DejaVure/RP-Hausarbeit/deckblatt.tex

\begin{titlepage}
	\begin{flushright}
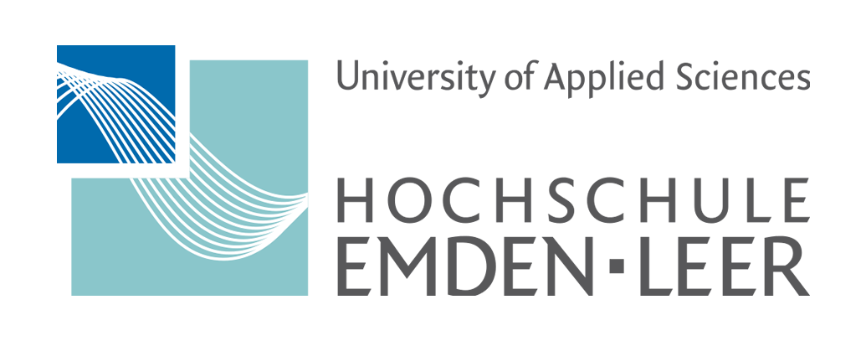
[picture p1: 1_Abbildungen/logoHSEL.png]
		
	\end{flushright}
	\vspace{1 cm}
	\centering
	{\LARGE \textbf{Projektarbeit - Rapid Prototyping}}\\[1cm]
	Studiengang: Maschinenbau \& Design\\
	Abgabedatum: 1. September 2026\\
	\vspace{1cm}
	\textbf{Aufgabe: Halter für die Getriebeausstellung entwerfen und drucken.}\\

	%\today\\[0.25cm]
	\vfil
	%\rule{\textwidth}{0.5pt}
	\vfill
	
	\begin{figure}[H]
		\centering
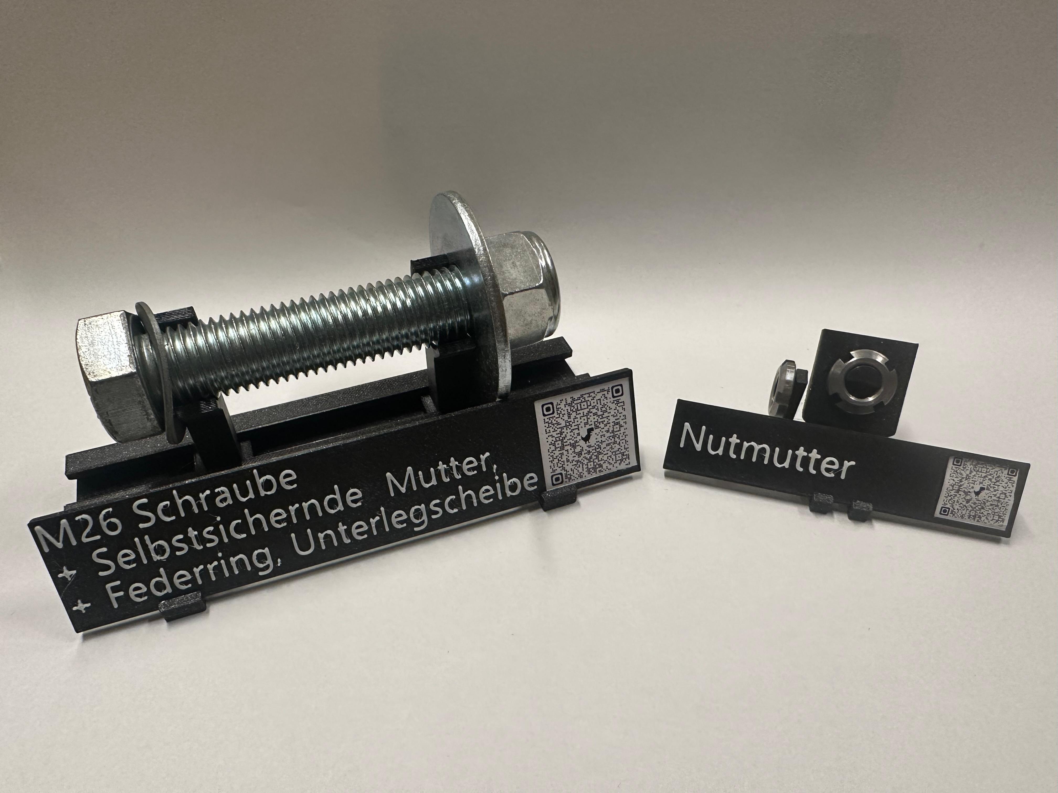
[picture p2: 1_Abbildungen/alleTeile.png]
		
		%\caption{Beispielabbildung}
		%\label{fig:beispiel}
	\end{figure}
	
	\vfill
	
	\begin{tabular}{ll}
		\textbf{Gruppe 4} & \\
		\hline
		Name & Matrikelnummer \\
		\hline
		Carl Maschke   & 7024640 \\
		Sven Neumann   & 7025068 \\
		\hline
	\end{tabular}
	
	\vfill
\end{titlepage}
