DejaVure/RP-Hausarbeit/header.tex

\usepackage[a4paper, top=2cm, bottom=3cm, left=2.5cm, right=2.5cm]{geometry}

\usepackage[utf8]{inputenc}
\usepackage[T1]{fontenc}
\usepackage[ngerman]{babel}

\usepackage{pdfpages}  

\usepackage{subcaption}
\renewcommand{\thesubfigure}{\arabic{subfigure}}

\usepackage{comment}
\usepackage{graphicx}
\usepackage{amsmath}
\usepackage{siunitx}
\usepackage{booktabs}
\usepackage{float}
%\usepackage{hyperref} ersetzt mit Zeile unten, legt Farben für Links fest
\usepackage[colorlinks=true, linkcolor=black, citecolor=black, urlcolor=black]{hyperref}
\usepackage{makecell}
\usepackage{rotating}
\usepackage{cellspace}
\usepackage{tabularx}
\usepackage{array}
\usepackage{caption}

\graphicspath{{1_Abbildungen/}}
\sisetup{locale = DE}

\usepackage{fancyhdr}
\setlength{\parindent}{0pt}
\setlength{\parskip}{0pt}

% ===== biblatex einbinden =====
\usepackage[style=authoryear, backend=biber]{biblatex}

% Zitierformat auf Nur-Norm-Kennung umstellen
\DeclareFieldFormat{cite}{\mkbibparens{#1}}
\renewbibmacro*{cite}{%
	\printfield{number}%
	\setunit{\addcolon\addspace}%
	\printfield{year}%
}

\addbibresource{2_Quellen/literatur.bib} % Pfad zu deiner Bib-Datei
