DejaVure/RP-Hausarbeit/0_Kapitel/Diskussion.tex

\section{Diskussion}
\begin{comment}
	\textcolor{red}{Abgleich mit den Zielsetzungs-Kriterien, Druckherausforderungen (Schwindung, Stützstrukturen, Nacharbeit), Abweichungen.}
\end{comment}

Die aufgetretenen Druckfehler können auf mehrere mögliche Ursachen zurückgeführt werden. Das beobachtete Stringing könnte auf einen erhöhten Feuchtigkeitsgehalt des verwendeten Filaments hindeuten. Durch die im Filament enthaltene Feuchtigkeit kann es beim Erhitzen zu einer unkontrollierten Materialabgabe aus der Düse kommen. Als weitere mögliche Ursache kommen nicht optimal eingestellte Drucktemperaturen infrage. Eine zu hohe Drucktemperatur kann dazu führen, dass das Filament während der Leerfahrten stärker aus der Düse austritt.\\

Die festgestellten Einfallstellen können ebenfalls verschiedene Ursachen haben. Eine mögliche Ursache ist der Verzicht auf Stützstrukturen. Insbesondere bei Bereichen mit Überhängen kann das aufgetragene Filament ohne ausreichende Unterstützung nicht vollständig getragen werden und sich verformen. Alternativ kann auch ein ungünstiger Druckablauf für die Entstehung der Einfallstellen verantwortlich sein.\\

Da alle Haltearme in gleicher Orientierung gedruckt wurden und die Einfallstellen bei allen Bauteilen an derselben Stelle auftraten, ist ein Zusammenhang mit dem Druckablauf wahrscheinlich. Eine mögliche Erklärung ist, dass die Düse an dieser Stelle jeweils einen Schichtwechsel durchgeführt oder dort die Druckbahn beendet hat. Dadurch könnte sich an dieser Stelle eine lokale Materialanhäufung oder eine ungleichmäßige Abkühlung ergeben haben, wodurch die sichtbare Verformung entstanden sein könnte.

\subsection{Vergleich mit der Anforderungsliste}
Abschließend folgt der Vergleich mit der Anforderungsliste aus Tabelle \ref{tab:zielsetzung}. Die Standsicherheit ist trotz des 15 \% Infills gegeben. Der Halter für die Wellensicherungen hat eine gute Standsicherheit durch sein Eigengewicht. Der Schrauben-Halter hat eine gute Standsicherheit durch das Gewicht der Schrauben. Die Funktion der Maschinenelemente ist bei beiden Haltern sichtbar. Es wurde kostengünstig und materialsparend gearbeitet (190,74 g Filament). Zudem wurden die QR-Codes weitergeführt und die Informativität im Vergleich zu vorher erhöht.
