DejaVure/RP-Hausarbeit/0_Kapitel/Einleitung.tex

\section{Einleitung}
Rapid-Prototyping gewinnt heutzutage immer mehr an Bedeutung. Innerhalb kürzester
Zeit ist ein Bauteil entworfen und mittels 3D-Druck gefertigt. Das spart nicht nur Kosten
für aufwändige Prototypen mit langer Fertigungsdauer, sondern bietet auch den Rahmen
für kleinere Bauteile und Projekte. Diese kleinen Projekte können jedoch eine große
Wirkung erzielen, indem sie individuelle Lösungen erlauben, die vorher nur durch teure
Einzelfertigungen möglich waren.\\

Solch eine individuelle Lösung ist auch im Rahmen des Moduls \textit{Rapid Prototyping}
entstanden. Dabei handelt es sich um eine studentische Projektarbeit im Bereich der
additiven Fertigung mit dem Auftrag, für das Labor für Maschinenelemente Bauteile zu
entwerfen, die als Halter für Verbindungselemente dienen und anschließend additiv
gefertigt werden.\\

 Die vorgefundene Situation im Labor erfordert dabei eine sichere und
didaktisch sinnvolle Halterung für die ausgestellten Maschinenelemente. Nach der
Konzeptfindung wird daher ein Bauteil entworfen und kostengünstig gedruckt.

\subsection{Aufbau der Arbeit}

Anfangs wird die Problemstellung im Labor beschrieben. Daraufhin wird die Zielsetzung
der Gruppenarbeit festgelegt, wobei die genauen Randbedingungen des Bauteils
festgehalten werden. Bevor konstruktiv an dem Bauteil gearbeitet wird, erfolgt eine
Marktrecherche. Im Anschluss werden Lösungsansätze erarbeitet und ein Konzeptvergleich
durchgeführt. Danach folgt die konstruktive Umsetzung. Im nächsten Schritt werden die
Ergebnisse präsentiert und die Ziele im Kapitel Diskussion auf ihre Erfüllung geprüft.
Abschließend folgen ein Fazit sowie ein Ausblick auf weitere Bauteile und Verbesserungen.
