DejaVure/RP-Hausarbeit/main.tex

\documentclass[a4paper,12pt]{article}

\input{Header}

\begin{document}
	
	% =========================
	% Deckblatt (ohne Kopfzeile)
	% =========================
	%\pagestyle{empty}
	
	\input{Deckblatt}
	
	\clearpage
	% =========================
	% Inhaltsverzeichnis
	% =========================
	\pagestyle{empty}
	\tableofcontents
	\clearpage
	% =========================
	% Kopf- und Fußzeilen nach dem Inhaltsverzeichnis
	% =========================
	\pagestyle{fancy}
	\fancyhf{}
	% Kopfzeile
	\fancyhead[L]{}
	\fancyhead[R]{\small \nouppercase{\leftmark}}
	% Fußzeile
	\fancyfoot[L]{\small 1. September 2026}
	\fancyfoot[C]{\small Hausarbeit Rapid Prototyping}
	\fancyfoot[R]{\small \thepage}
	% Linien
	\renewcommand{\headrulewidth}{0.4pt}
	\renewcommand{\footrulewidth}{0.4pt}
	\setlength{\headheight}{32pt}
	% =========================
	% Hauptteil
	% =========================
	\input{0_Kapitel/Einleitung}
	\newpage
	\input{0_Kapitel/Problemstellung}
	\newpage
	\input{0_Kapitel/Zielsetzung}
	\newpage
	%\input{0_Kapitel/Aufbau der Arbeit}
	\newpage
	\input{0_Kapitel/Stand der Technik}
	\newpage
	\input{0_Kapitel/Methoden}
	\newpage
	\input{0_Kapitel/Ergebnisse}
	\newpage
	\input{0_Kapitel/Diskussion}
	\newpage
	\input{0_Kapitel/Zusammenfassung und Fazit}
	\newpage	
	\input{0_Kapitel/Ausblick}	
	\newpage
	% =========================
	% Literatur
	% =========================
	\clearpage
	\pagenumbering{roman}
	\printbibliography[heading=bibintoc]
	\clearpage
	\addcontentsline{toc}{section}{Abbildungsverzeichnis}
	\listoffigures
	\clearpage
	\addcontentsline{toc}{section}{Tabellenverzeichnis}
	\listoftables
	\appendix
	\newpage
	\section{Baugruppenzeichnungen}
	\includepdf[pages=1]{3_Anhang/Zeichnungen/Wellensicherung.pdf}
	\includepdf[pages=1]{3_Anhang/Zeichnungen/Schraubenhalter.pdf}

\end{document}
