DejaVure/RP-Hausarbeit/0_Kapitel/Methoden.tex

\section{Konstruktive Umsetzung}

Für die Herstellung der Bauteile wurde das FDM-Verfahren mit den in Tab.~\ref{tab:Prozessparameter für die Herstellung der Bauteile} aufgeführten Prozessparametern und Materialien verwendet.

\begin{table}[H]
	\centering
	\caption{Prozessparameter für die Herstellung der Bauteile}
	\label{tab:Prozessparameter für die Herstellung der Bauteile}
	\begin{tabular}{c|c}		
		\textbf{Prozessparameter} & \textbf{Wert/Einstellung} \\
		\hline
		Hauptfilament & PLA Prusa Galaxy Black \\
		\hline
		Schriftfilament & PLA Weiß \\
		\hline
		Drucktemperaturen & Düse 215\,°C, Druckbett 60\,°C \\
		\hline
		Infill & 15\,\% \\
		\hline
		Schichthöhe & max. 0,2\,mm \\
		\hline
		Druckqualität & hoch \\
	\end{tabular}
\end{table}

Um möglichst viel Filament einzusparen, wurden die Bauteile so konstruiert und auf dem Druckbett ausgerichtet, dass bis auf die Adapter für die Sicherungen keine Stützstrukturen benötigt werden. Dies wurde dadurch erreicht, dass die Neigungen der Bauteile einen Winkel von 45° nicht unterschreiten und Übergänge, soweit möglich, durch Schrägen ausgeführt wurden. Für alle Bauteile, die ineinander gesteckt oder aufgesteckt werden, wurden Toleranzen von 0,1--0,3\,mm berücksichtigt.

Für die Informationstexte wurde der Slicer von Prusa verwendet. Dafür wurde eine unbeschriftete Platte mit den Abmessungen 150\,x\,30\,mm für die Schraubenbeschriftung und eine Platte mit den Abmessungen 90\,x\,20\,mm für die Sicherungen als Grundplatte in den Slicer importiert, siehe Abb. \ref{fig:Platen im Slicer}. Anschließend wurden die gewünschten Beschriftungen mit der Funktion ``Text'' auf die Platten aufgetragen. Um einen farblichen Kontrast zur Grundplatte zu schaffen, wurde ab der ersten Schicht der Beschriftung ein Farbwechsel eingeplant.

\begin{figure}[H]
	\centering
	
	\caption{Platte für die Sicherungen mit Einlassung zum Einklemmen von QR-Codes}
	\label{fig:Platte in Fusion}
\end{figure}

In die Platten wurden zusätzlich Einlassungen konstruiert, um die QR-Codes zur Internetseite des Maschinenelemente-Labors einzuklemmen (siehe Abb.~\ref{fig:Platte in Fusion}). Dies wurde umgesetzt, da es technisch nicht möglich war, die QR-Codes in einer für die Platte geeigneten Größe direkt auf die Platten aufzubringen und gleichzeitig eine ausreichende Lesbarkeit sicherzustellen.

\begin{figure}[H]
	\centering
	
	\caption{Beschriftete Platten für die Sicherungen im Slicer}
	\label{fig:Platen im Slicer}
\end{figure}

%//////////////////////////////////////////////////////////////////////////////////

\subsection{Halter für die Schrauben}

Um die Möglichkeit zu schaffen, bei einem Tausch oder Hinzufügen von Schrauben mit unterschiedlichen Längen nicht die gesamte Halterung neu konstruieren zu müssen, wurde die Basis des Schraubenhalters mit einer Schiene konstruiert. Diese ermöglicht die Einstellung unterschiedlicher Abstände (siehe Abb.~\ref{fig:Schrauben_Basis}).

Um die Platten mit den Informationstexten halten zu können, wurden die Arme der Basis mit schrägen Einkerbungen versehen. Diese ermöglichen das Einsetzen und Halten der Platten (siehe Abb.~\ref{fig:Schrauben_Basis}).

\begin{figure}[H]
	\centering
	
	\caption{Basis des Schraubenhalters}
	\label{fig:Schrauben_Basis}
\end{figure}

Um auch verschiedene Schraubendurchmesser ausstellen zu können, wurde für die Haltearme ein Mustermodell erstellt. In diesem Modell kann der gewünschte Durchmesser direkt in der Skizze eingegeben werden, woraufhin die restlichen Maße automatisch angepasst werden. Durch die Schienen an der Basis und die entsprechenden Gegenstücke an den Haltearmen können die Haltearme einfach ausgetauscht werden.

\begin{figure}[H]
	\centering
	
	\caption{Haltearme der Schrauben für die unterschiedlichen Schraubendurchmesser}
	\label{fig:Haltearme_Schrauben}
\end{figure}

Die Grundfläche der gesamten Halterung beträgt 150\,x\,87\,mm. Da die Haltearme mit unterschiedlichen Durchmessern auch unterschiedlich hoch sind, liegt die Höhe der Halterung zwischen 46,62\,mm für die M16-Schraube und 60,25\,mm für die M33-Dehnschraube. Die fertige Halterung für die Schrauben ist in Abb. \ref{fig:schraubenhalter} zu sehen.

\begin{figure}[H]
	\centering
	
	\caption{CAD-Modell des fertigen Schraubenhalters}
	\label{fig:schraubenhalter}
\end{figure}

%//////////////////////////////////////////////////////////////////////////////////

\subsection{Halter für die Wellensicherungen}

Von den Sicherungen sind jeweils zwei Exemplare in der Glasvitrine vorhanden. Daher wurde eine Basis gewählt, bei der jeweils eine Sicherungsart in der Frontansicht angeordnet wird und die zweite Ausführung in der Seitenansicht daneben hängt. Die Platte mit dem Informationstext wird ähnlich wie bei der Schraubenhalterung in die Stützen der Basis eingesteckt (siehe Abb.~\ref{fig:Basis_Sicherungen}).

\begin{figure}[H]
	\centering
	
	\caption{Basis der Halterung für die Sicherungen}
	\label{fig:Basis_Sicherungen}
\end{figure}

\newpage

Um auch hier die Möglichkeit zu schaffen, verschiedene Sicherungselemente mit unterschiedlichen Durchmessern ausstellen zu können, werden sogenannte Adapter (siehe Abb.~\ref{fig:Adapter_Sicherungen}) in die Öffnung der Basis gesteckt. Die Adapter wurden so konstruiert, dass entweder möglichst viele Details der jeweiligen Sicherung sichtbar sind oder die vorgesehene Verwendung der Sicherung angedeutet wird.

\begin{figure}[H]
	\centering
	
	\caption{Passende Adapter für die auszustellenden Sicherungen}
	\label{fig:Adapter_Sicherungen}
\end{figure}

Die Maße der Halterung betragen 43,34\,x\,33\,x\,30,24\,mm. Das fertige CAD-Modell für den Halter der Wellensicherungen ist in Abb. \ref{fig:wellensicherungHalter} zu sehen.

\begin{figure}[H]
	\centering
	
	\caption{CAD-Modell des fertigen Wellensicherungs-Halters}
	\label{fig:wellensicherungHalter}
\end{figure}
