DejaVure/RP-Hausarbeit/0_Kapitel/Stand der Technik.tex

\section{Stand der Technik}

\subsection{Marktrecherche}
Im Internet sind viele Werkzeughalter zu finden. Diese sind jedoch auf bestimmte Werkzeuge, aber nicht auf einzelne Maschinenelemente abgestimmt. Als Beispiel dient ein Wandhalter für Werkzeug von \textit{Amazon} (siehe Abb. \ref{fig:amazonHalter}).

\begin{figure}[H]
	\centering
	
	\caption{Kommerzieller Halter für Werkzeug (Amazon.de:2026)} \nocite{Amazon2026}
	\label{fig:amazonHalter}
\end{figure}

Eine Halterung aus Holz wäre nachhaltiger als ein Filament aus dem 3D-Drucker, jedoch für das Modul Rapid-Prototyping nicht relevant, da die additive Fertigung Teil der Aufgabenstellung ist.\\

Des Weiteren sind auch Lochwände als allgemeine Werkstattlösung zur geordneten Platzierung von Werkzeug geeignet. Hier gibt es jedoch auch keine geeigneten verfügbaren Halter für einzelne Maschinenelemente; lediglich für definiertes Werkzeug, wie in Abb. \ref{fig:lochwand} zu sehen ist. Auch hier müssten erst individuelle Halter für die Lochwand gefertigt werden (auch als 3D-Druck möglich).

\begin{figure}[H]
	\centering
	
	\caption{Kommerzielle Lochwand für Werkzeug (Lochwand.de:2026)} \nocite{Lochwand2026}
	\label{fig:lochwand}
\end{figure}

\subsection{Lösungsansätze}
\subsubsection{Schraubenhalter}
Für den Schraubenhalter wurde zuerst die Idee der Lochwand aufgegriffen, wie in Abb. \ref{fig:halter1} zu sehen ist. Dabei müssen der Halter und das Lochbrett jeweils gefertigt werden. Das Lochbrett hat ein einheitliches Muster und kann auch für spätere Anwendungen genutzt werden. Der Halter benötigt auf der einen Seite eine Aufnahme für die Schraube und auf der anderen Seite einen Stift, um sich formschlüssig oder durch eine Klemmverbindung mit dem Lochbrett zu verbinden.
\begin{figure}[H]
	\centering
	
	\caption{Konzept 1 für Schraubenhalter}
	\label{fig:halter1}
\end{figure}

Eine weitere Idee ist ein variabler Halter, der mit Adaptern jede Schraube tragen kann (siehe Abb. \ref{fig:halter2}). Bei diesem Konzept wird der Halter einmal gefertigt und es müssen lediglich die Adapter verändert werden, damit man die Schrauben variieren kann. 

\begin{figure}[H]
	\centering
	
	\caption{Konzept 2 für Schraubenhalter}
	\label{fig:halter2}
\end{figure}
\newpage

\subsubsection{Wellensicherungs-Halter}
Für den Wellensicherungs-Halter ist die Idee mit dem Lochbrett ebenfalls aufgenommen worden (siehe Abb. \ref{fig:halter3}). Dabei kann man einen Wellenabsatz in das Lochbrett stecken und das Wellensicherungselement auf die Welle montieren.

\begin{figure}[H]
	\centering
	
	\caption{Konzept 1 für Wellensicherungs-Halter}
	\label{fig:halter3}
\end{figure}

Ein weiteres Konzept ist ein Halter mit geneigter Fläche (siehe Abb. \ref{fig:halter4}). Dabei werden die Wellensicherungen auf einer geneigten Grundfläche ebenfalls auf kleinen Wellenabsätzen montiert. Zusätzlich ist eine Infotafel mit der Möglichkeit eines QR-Codes verbaut.

\begin{figure}[H]
	\centering
	
	\caption{Konzept 2 für Wellensicherungs-Halter}
	\label{fig:halter4}
\end{figure}
\newpage

\subsection{Konzeptvergleich}
Zuerst werden die beiden Konzepte mit den gewichteten Kriterien aus Tabelle \ref{tab:zielsetzung} in einer Bewertungsmatrix verglichen, siehe Tabelle \ref{tab:bewertung_schraubenhalter}. Dabei wird eine Punkteskala von 0-10 (0 = schlecht, 10 = sehr gut) verwendet. 

\begin{table}[H]
	\centering
	\caption{Bewertungsmatrix Schraubenhalter}
	\label{tab:bewertung_schraubenhalter}
	\begin{tabular}{l c cc cc}
		\toprule
		& & \multicolumn{2}{c}{Konzept 1: Lochbrett} & \multicolumn{2}{c}{Konzept 2: Adapter} \\
		\cmidrule(lr){3-4} \cmidrule(lr){5-6}
		Kriterium & Gewichtung & Punkte & Gewichtet & Punkte & Gewichtet \\
		\midrule
		Tragfähigkeit   & 0,25 & 7 & 1,75 & 9 & 2,25 \\
		Standsicherheit & 0,20 & 5 & 1,00 & 9 & 1,80\\
		Materialsparend & 0,15 & 6 & 0,90 & 5 & 0,75\\
		Kostengünstig   & 0,15 & 6 & 0,90 & 5 & 0,75\\
		Wenig Bauteile  & 0,10 & 9 & 0,90 & 3 & 0,30\\
		Informativ      & 0,10 & 3 & 0,30 & 3 & 0,30\\
		Ästhetisch      & 0,05 & 4 & 0,20 & 5 & 0,25\\
		\midrule
		\textbf{Summe}  & 1,00 & & \textbf{5,95} & & \textbf{6,40} \\
		\bottomrule
	\end{tabular}
\end{table}

Aus der Tabelle \ref{tab:bewertung_schraubenhalter} geht das Konzept 2 als besser hervor. Für die beiden Konzepte der Wellensicherungs-Halter wurde ebenfalls eine Bewertungsmatrix angelegt (siehe Tabelle \ref{tab:bewertung_wellensicherung})

\begin{table}[H]
	\centering
	\caption{Bewertungsmatrix Wellensicherungs-Halter}
	\label{tab:bewertung_wellensicherung}
	\begin{tabular}{l c cc cc}
		\toprule
		& & \multicolumn{2}{c}{Konzept 1: Lochbrett} & \multicolumn{2}{c}{Konzept 2: geneigte Fläche} \\
		\cmidrule(lr){3-4} \cmidrule(lr){5-6}
		Kriterium & Gewichtung & Punkte & Gewichtet & Punkte & Gewichtet \\
		\midrule
		Tragfähigkeit   & 0,25 & 8 & 2,00 & 10 & 2,50 \\
		Standsicherheit & 0,20 & 8 & 1,60 & 10 & 2,00\\
		Materialsparend & 0,15 & 7 & 1,05 & 5 & 0,75\\
		Kostengünstig   & 0,15 & 6 & 0,90 & 6 & 0,90\\
		Wenig Bauteile  & 0,10 & 8 & 0,80 & 8 & 0,80\\
		Informativ      & 0,10 & 4 & 0,40 & 10 & 1,00\\
		Ästhetisch      & 0,05 & 4 & 0,20 & 6 & 0,30\\
		\midrule
		\textbf{Summe}  & 1,00 & & \textbf{6,95} & & \textbf{8,25} \\
		\bottomrule
	\end{tabular}
\end{table}

Aus der Tabelle \ref{tab:bewertung_wellensicherung} geht das Konzept 2 als bessere Variante hervor.
