DejaVure/RP-Hausarbeit/0_Kapitel/Ergebnisse.tex

\section{Ergebnisse}

\begin{comment}
	\textcolor{red}{Renderings, Slicer-Vorschau, Druckfotos, Soll-Ist-Maßvergleich, Gewicht/Druckzeit als Beleg für "materialsparend" aus der Zielsetzung.}
\end{comment}

Die 3D-erzeugten Bauteile konnten mit 190,74 g (63,96 m) an Filament hergestellt werden. Bei fast allen Bauteilen konnte auf Stützstrukturen verzichtet werden, wodurch Zeit und Material eingespart werden konnten. Trotz eines Infills von 15\,\% konnten die Bauteile ausreichend stabil und standsicher hergestellt werden. Die Arme an den Halterungen sowie die Haltearme für die Schrauben wurden hierfür etwas massiver ausgelegt.

Aufgrund der relativ großen Schrift auf den Platten mussten Informationen zu den Schrauben teilweise weggelassen werden. Die Qualität der Schrift weist an mehreren Stellen sichtbare Druckfehler auf (siehe Abb.~\ref{fig:Schrift der Platten}).

\begin{figure}[H] 
	\centering 
	
	\caption{Druckfehler bei der erzeugten Schrift} 
	\label{fig:Schrift der Platten} 
\end{figure}

Die Bauteile konnten bis auf wenige Stellen, an denen Stringing aufgetreten ist, nahezu fehlerfrei hergestellt werden. Bei einer Basis für eine Sicherungshalterung ist im Bereich des Lochs das Material etwas eingefallen (siehe Abb.~\ref{fig:Einfall in Loch}).

\begin{figure}[H]
	\centering
	
	\caption{Druckfehler: eingefallene Stelle im Loch}
	\label{fig:Einfall in Loch}
\end{figure}

Bei allen Haltearmen des Schraubenhalters ist von hinten gesehen auf der rechten Seite eine Einfallstelle am Außendurchmesser zu erkennen (siehe Abb.~\ref{fig:Einfall im Haltearm}).

\begin{figure}[H]
	\centering
	
	\caption{Druckfehler: eingefallene Stelle am Haltearm}
	\label{fig:Einfall im Haltearm}
\end{figure}

Die jeweiligen technischen Zeichnungen zu den Haltern sind dem Anhang zu entnehmen.

\newpage

\subsection{Der fertige Halter für Schrauben}

\begin{figure}[H]
	\centering
	
	\caption{Schraubenhalter mit M26 Schraube}
	\label{fig:schraubenhalterFinal}
\end{figure}

\subsection{Der fertige Halter für Wellensicherungen}

\begin{figure}[H]
	\centering
	
	\caption{Die fertigen Halter für Wellensicherungen}
	\label{fig:wellenhalterFinal}
\end{figure}
