DejaVure/RP-Hausarbeit/0_Kapitel/Problemstellung.tex

\section{Problemstellung}

Im Labor für Maschinenelemente sind mechanische Verbindungs- und Maschinenelemente ausgestellt. Einige dieser Bauteile sind in einer Glasvitrine ausgestellt (siehe Abb. \ref{fig:schraubenGesamt}). Das Problem hierbei ist, dass einige der mechanischen Verbindungselemente ein hohes Gewicht haben und beim unbeabsichtigt zu starken Ablegen das Glas beschädigen könnten. Zudem liegen die Bauteile ungeordnet frei herum. Die einzelnen Schrauben sind zudem in Abb. \ref{fig:schrauben} zu sehen.

\begin{figure}[H]
	\centering
	
	\caption{Verbindungselemente liegen auf der Glasplatte}
	\label{fig:schraubenGesamt}
\end{figure}

Zusätzlich befinden sich noch axiale Wellensicherungselemente in der Glasvitrine, siehe dazu Abb. \ref{fig:sicherungsringe}. \\
In Abb. \ref{fig:sicherungsringe} liegen die Sicherungselemente auf einer Holzplatte für eine bessere Sichtbarkeit. Diese liegen ebenfalls regellos in der Vitrine und sind schlecht sichtbar. Zudem lässt sich die spätere Funktion als  Maschinenelement auf den ersten Blick nicht erkennen.

\begin{figure}[H]
	\centering
	
	\caption{Axiale Wellensicherungen sind ungeordnet verteilt}
	\label{fig:sicherungsringe}
\end{figure}
\newpage

Im Detail sind es folgende Schrauben und Wellensicherungen:
\begin{enumerate}
	\item Schraubenbolzen mit Dehnschaft M33 x 180 mm \parencite{DIN2510}
	\item Sechskantschraube mit Schaft M24 x 120 mm \parencite{DIN931}
	\item Sechskantschraube mit Vollgewinde M16 x 80 mm \parencite{DIN933}
	\item Sechskantschraube mit Vollgewinde M20 x 100 mm \parencite{DIN933}
	\item Nutmutter M10 x 1 \parencite{DIN981}
	\item Sicherungsring für Wellen \O10 mm \parencite{DIN471}
	\item Sicherungsblech für Nutmutter \O10 mm \parencite{DIN5406}
\end{enumerate}

\begin{figure}[htbp]
	\centering
	
	% Oben
	\begin{subfigure}[c]{0.45\textwidth}
		\centering
		
		\caption{M33 -- DIN 2510}
		\label{fig:M33-DIN2510}
	\end{subfigure}
	\hfill
	\begin{subfigure}[c]{0.45\textwidth}
		\centering
		
		\caption{M24 -- DIN 931}
		\label{fig:M24-DIN931}
	\end{subfigure}
	
	\vspace{0.8cm}
	
	% Unten
	\begin{subfigure}[c]{0.45\textwidth}
		\centering
		
		\caption{M16 -- DIN 933}
		\label{fig:M16-DIN933}
	\end{subfigure}
	\hfill
	\begin{subfigure}[c]{0.45\textwidth}
		\centering
		
		\caption{M20 -- DIN 933}
		\label{fig:M20-DIN933}
	\end{subfigure}
	
	\caption{Verwendete Schrauben}
	\label{fig:schrauben}
\end{figure}
