DejaVure/RP-Hausarbeit/0_Kapitel/Zielsetzung.tex

\section{Zielsetzung}
Als Zielsetzung wurde die in Tabelle \ref{tab:zielsetzung} dargestellte Anforderungsliste nach Muss-/Soll-/Kann-Kriterien erstellt:\\

\begin{table}[H]
	\centering
	\caption{Anforderungsliste}
	\label{tab:zielsetzung}
	\begin{tabular}{c|c|c}		
		\textbf{Muss} & \textbf{Soll} & \textbf{Kann} \\
		\hline
		Tragfähigkeit & Informativ & Ästhetisch \\
		\hline
		Standsicherheit & Kostengünstig & Abnehmbare Infotafel \\
		\hline
		Additiv Fertigbar & Materialsparend & \\
		\hline
		Funktion sichtbar & Wenig Bauteile & \\
	\end{tabular}
\end{table}

Die Standsicherheit ist entscheidend für den Halter, da größere Verbindungselemente, wie die M33-Schraube, nicht auf die Glasvitrine fallen dürfen; andernfalls entsteht ein irreversibler Schaden an der Glasvitrine. Der Halter muss zudem das Gewicht des jeweiligen Maschinenelements tragen können; daher ist eine ausreichende Tragfähigkeit erforderlich, um ein späteres Zusammenbrechen des Halters zu vermeiden.\\

Die Funktion der Maschinenelemente soll deutlich gemacht werden. Dazu sollen die dazugehörigen Scheiben, Ringe und Muttern (vgl. Abb. \ref{fig:schraubenGesamt}) mit den Maschinenelementen auf dem Halter montiert sein. Materialsparend und wenig Bauteile gehen Hand in Hand: Es soll darauf geachtet werden, nicht für jede Schraube und Wellensicherung, ein komplett neuen Halter zu entwickeln, sondern mit Adaptern etc. zu arbeiten.\\

Auf Abb. \ref{fig:schraubenGesamt} sind bereits QR-Codes zu sehen, diese sollen erhalten bleiben und mit einer abnehmbaren Infotafel ergänzt werden. Damit bleibt das QR-Informationssystem des Labors erhalten.\\

Ästhetisch gesehen soll das Produkt auch ansprechend sein und das Interesse der Studenten wecken und gleichzeitig die Aufmerksamkeit auf das Maschinenelement lenken.
