DejaVure/RP-Hausarbeit/0_Kapitel/Ausblick.tex

\section{Ausblick}

%\textcolor{red}{Z. B. Übertragung auf weitere Vitrinen im Labor, Materialalternativen, Serienfertigung.}

Für zukünftige Anwendungen könnten die Druckparameter weiter optimiert werden, um die Qualität der gedruckten Schrift zu verbessern und Druckfehler wie Stringing und Einfallstellen zu reduzieren. Insbesondere die Drucktemperatur, die Retraktion und die Druckorientierung könnten angepasst und durch weitere Druckversuche optimiert werden.

Darüber hinaus könnte die Farbgestaltung der Halterungen und Bauteile angepasst werden, um einen stärkeren Kontrast zwischen den einzelnen Komponenten zu erreichen. Dadurch könnten die Bauteile in der Ausstellung besser voneinander unterschieden werden.

Auch die Beschriftung der Platten bietet weiteres Verbesserungspotenzial. Eine Anpassung der Schriftgröße und der verwendeten Schriftart könnte zu einer besseren Druckqualität führen. Alternativ könnte die Beschriftung nachträglich aufgebracht werden. Eine direkte Integration der QR-Codes in die Platten wäre ebenfalls wünschenswert, um auf das zusätzliche Ausdrucken und Anbringen verzichten zu können.

Durch die modulare Konstruktion besteht zudem die Möglichkeit, zukünftige Änderungen der Ausstellung mit vergleichsweise geringem Konstruktionsaufwand umzusetzen. Einzelne Halterungen können angepasst oder neu gefertigt werden, ohne die gesamte Konstruktion überarbeiten zu müssen.
