DejaVure/RP-Hausarbeit/1_Abbildungen/Adapter_Sicherungen.png

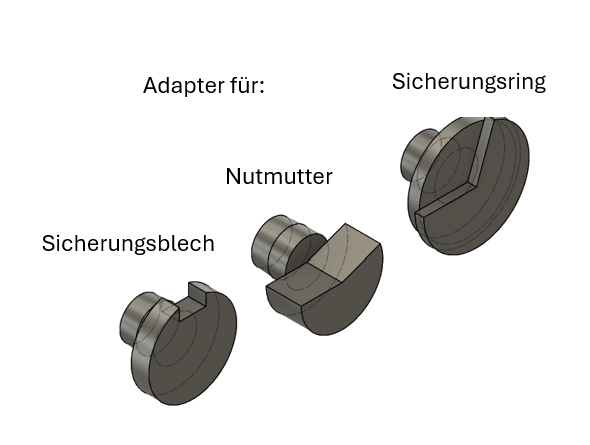
1_Abbildungen/Adapter_Sicherungen.png
