DejaVure/RP-Hausarbeit/1_Abbildungen/amazonHalter.png

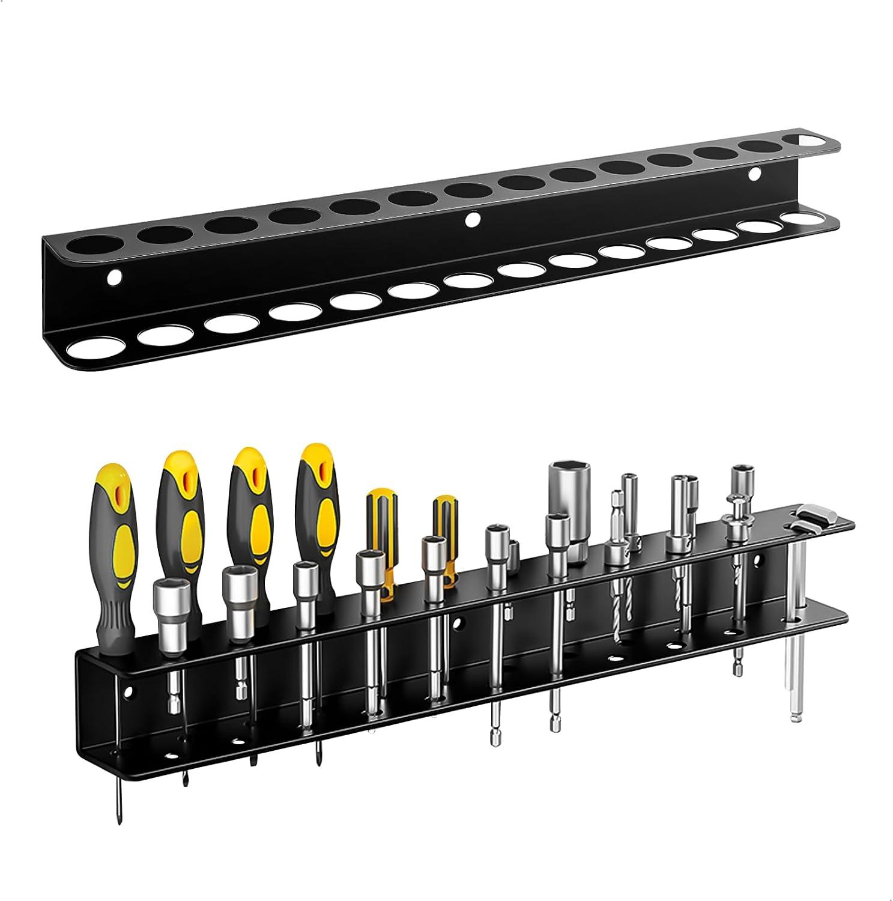
1_Abbildungen/amazonHalter.png
