DejaVure/RP-Hausarbeit/1_Abbildungen/Basis_Schrauben.png

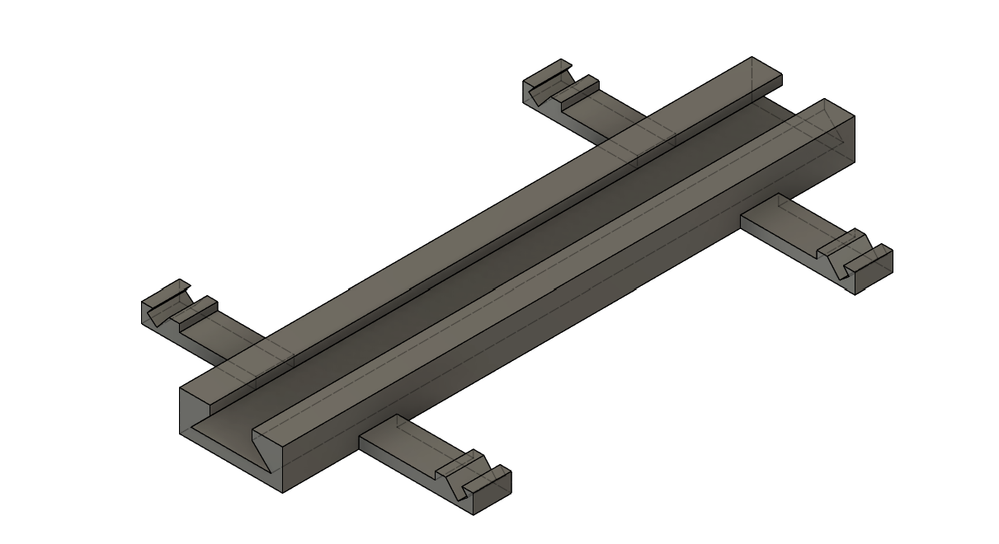
1_Abbildungen/Basis_Schrauben.png
