DejaVure/RP-Hausarbeit/1_Abbildungen/Basis_Sicherungen.png

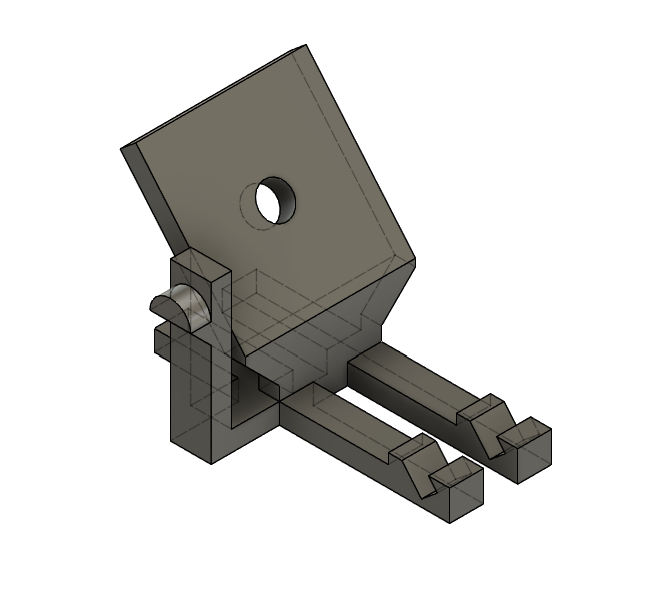
1_Abbildungen/Basis_Sicherungen.png
