DejaVure/RP-Hausarbeit/1_Abbildungen/Beschriftete Platten im Slicer .png

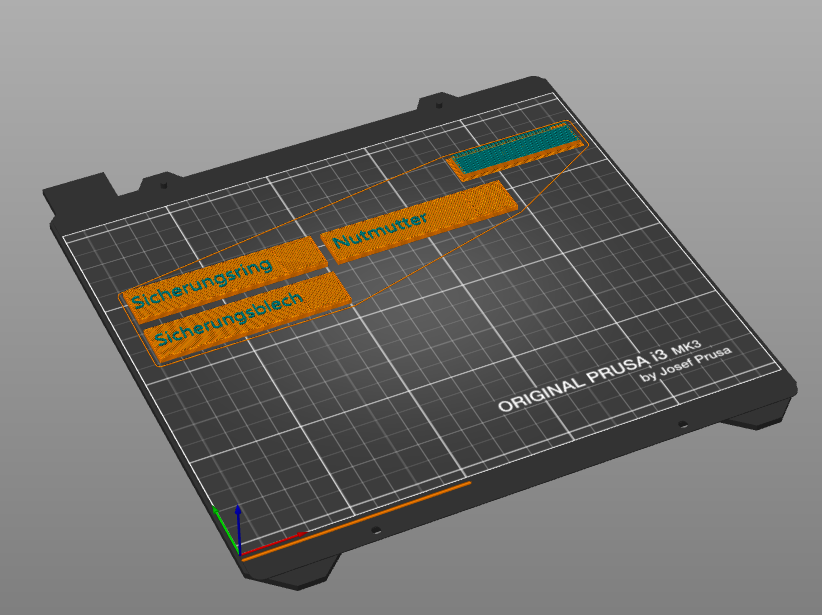
1_Abbildungen/Beschriftete Platten im Slicer .png
