DejaVure/RP-Hausarbeit/1_Abbildungen/dehnschraube.png

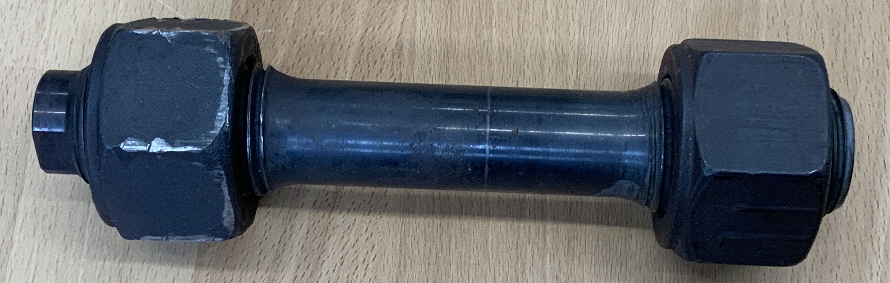
1_Abbildungen/dehnschraube.png
