DejaVure/RP-Hausarbeit/1_Abbildungen/Einfall im Haltearm.jpg

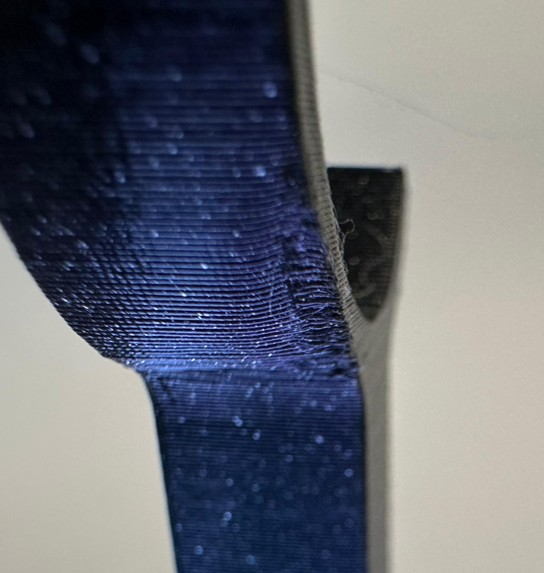
1_Abbildungen/Einfall im Haltearm.jpg
