DejaVure/RP-Hausarbeit/1_Abbildungen/Einfall im Loch.jpeg

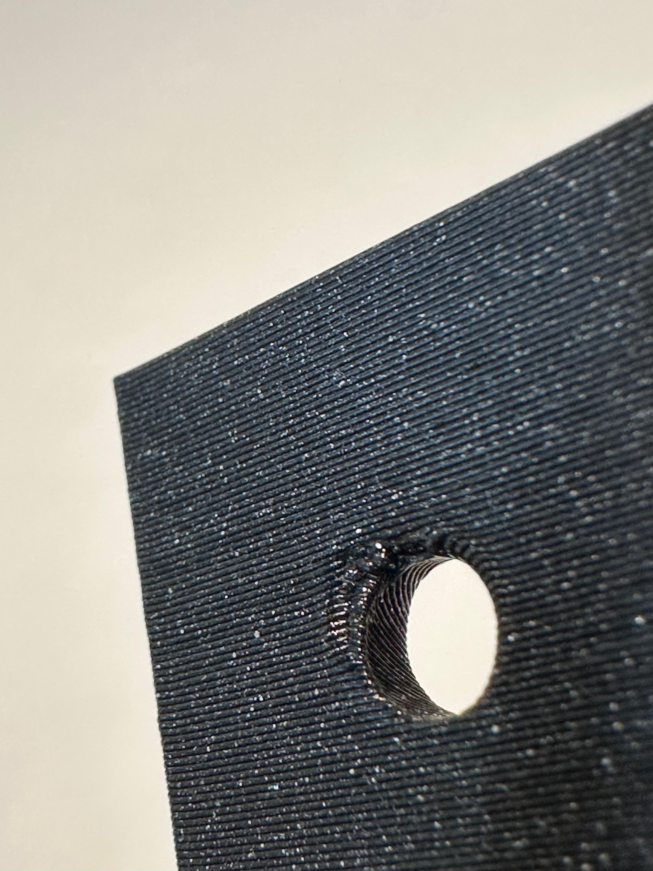
1_Abbildungen/Einfall im Loch.jpeg
