DejaVure/RP-Hausarbeit/1_Abbildungen/Haltearme_Schrauben.png

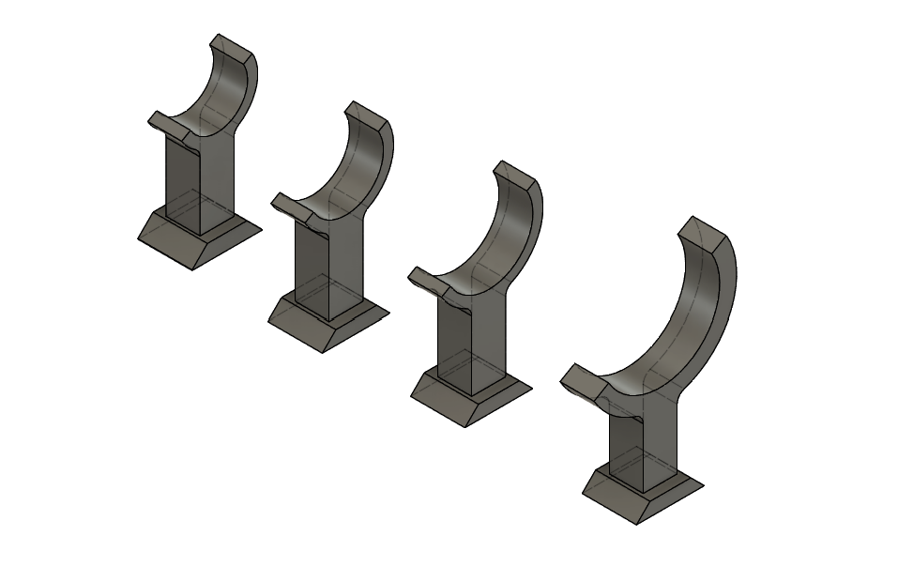
1_Abbildungen/Haltearme_Schrauben.png
