DejaVure/RP-Hausarbeit/1_Abbildungen/halter1.png

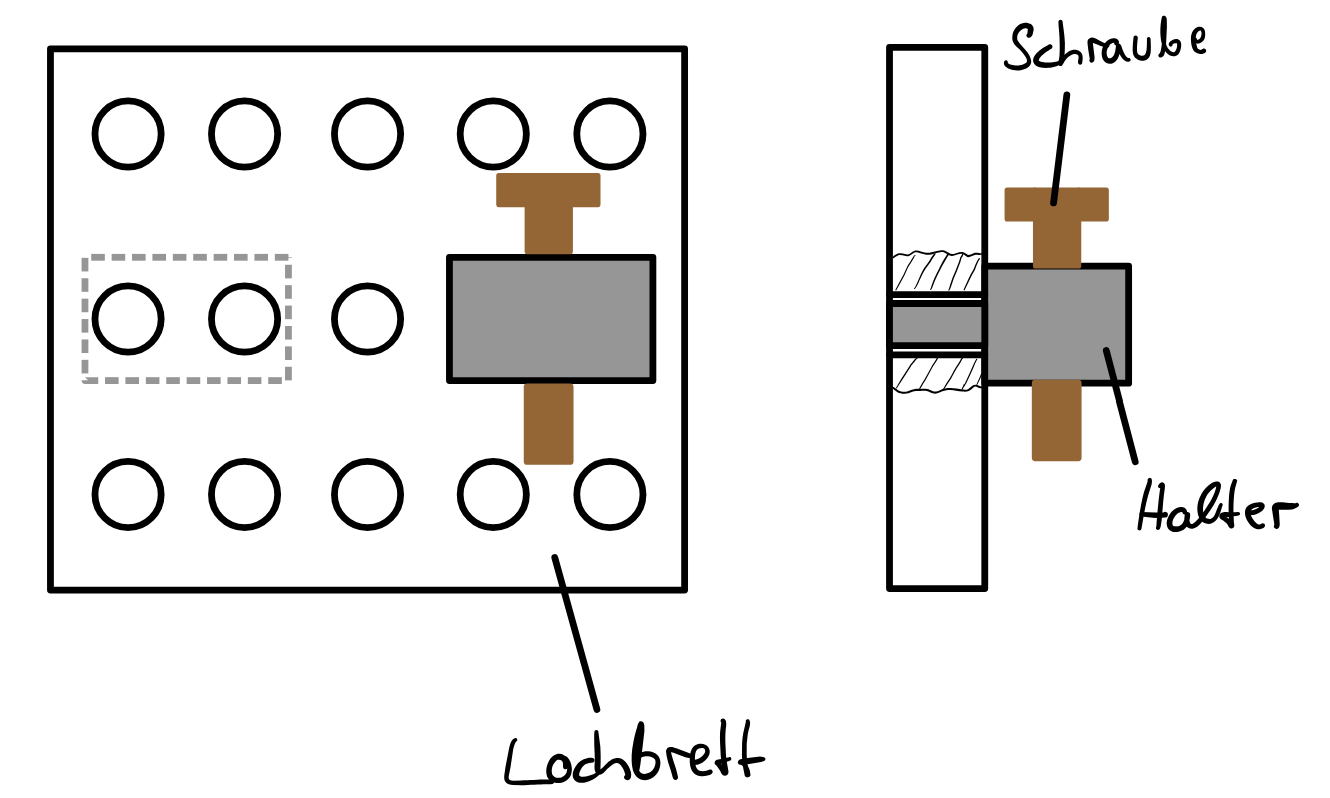
1_Abbildungen/halter1.png
