DejaVure/RP-Hausarbeit/1_Abbildungen/halter2.png

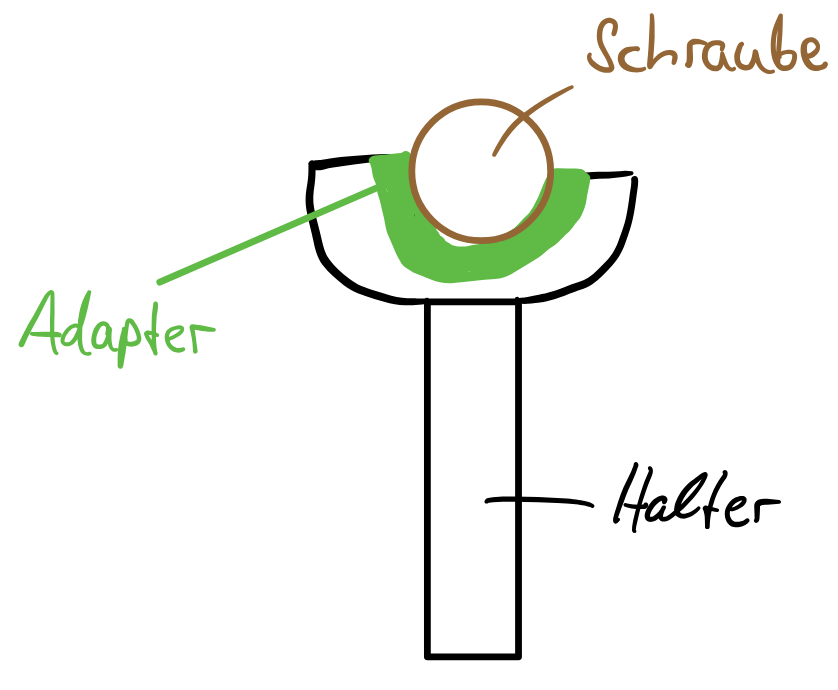
1_Abbildungen/halter2.png
