DejaVure/RP-Hausarbeit/1_Abbildungen/halter3.png

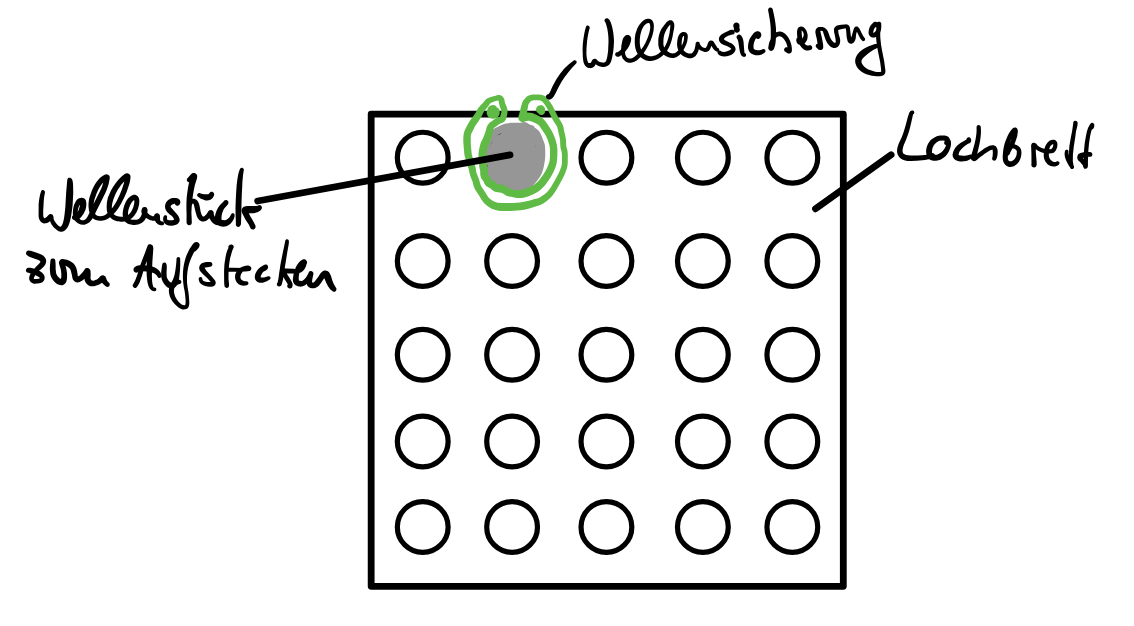
1_Abbildungen/halter3.png
