DejaVure/RP-Hausarbeit/1_Abbildungen/halter4.png

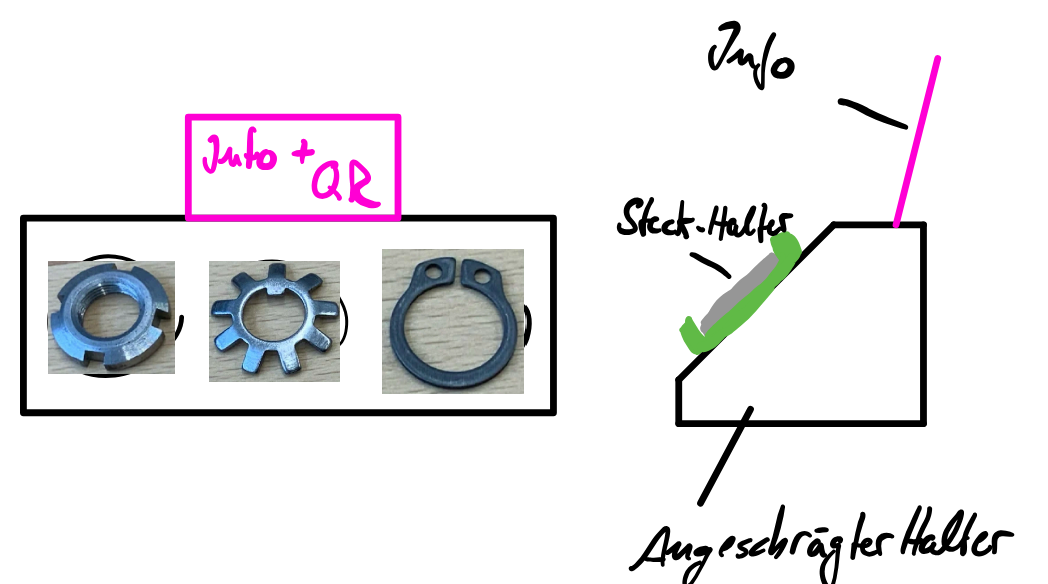
1_Abbildungen/halter4.png
