DejaVure/RP-Hausarbeit/1_Abbildungen/Halterung mit Sicherungsring.jpeg

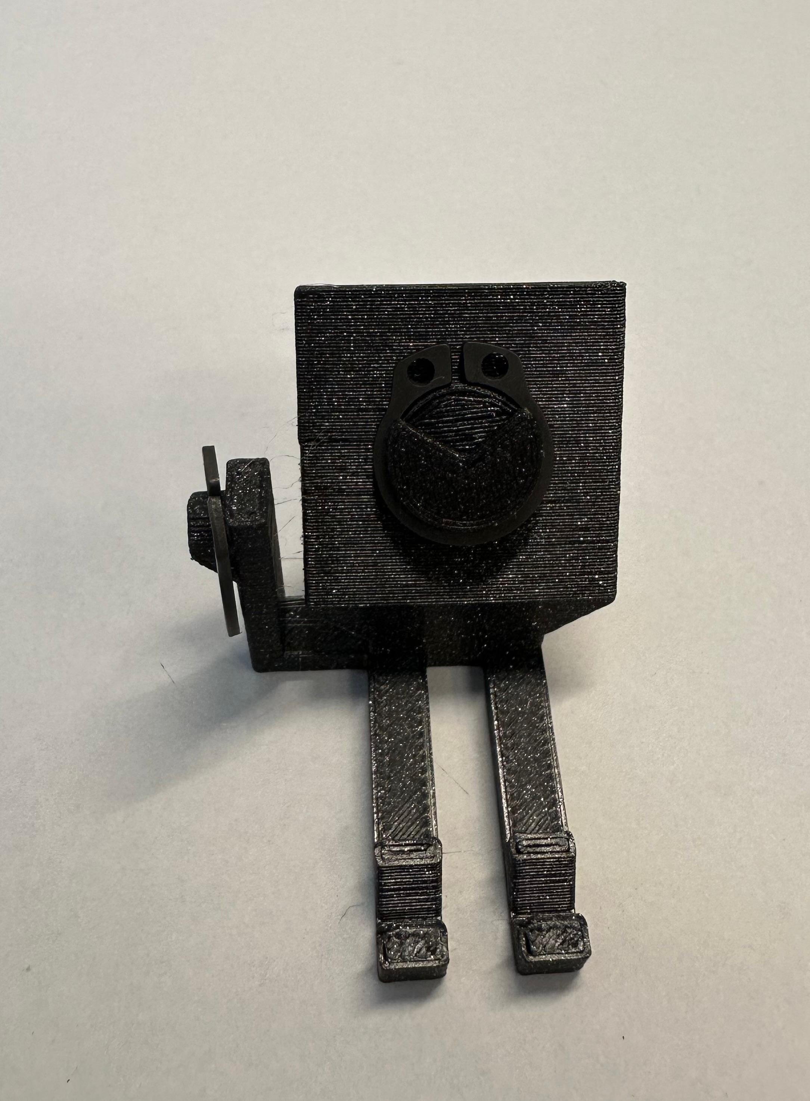
1_Abbildungen/Halterung mit Sicherungsring.jpeg
