DejaVure/RP-Hausarbeit/1_Abbildungen/lochwand.png

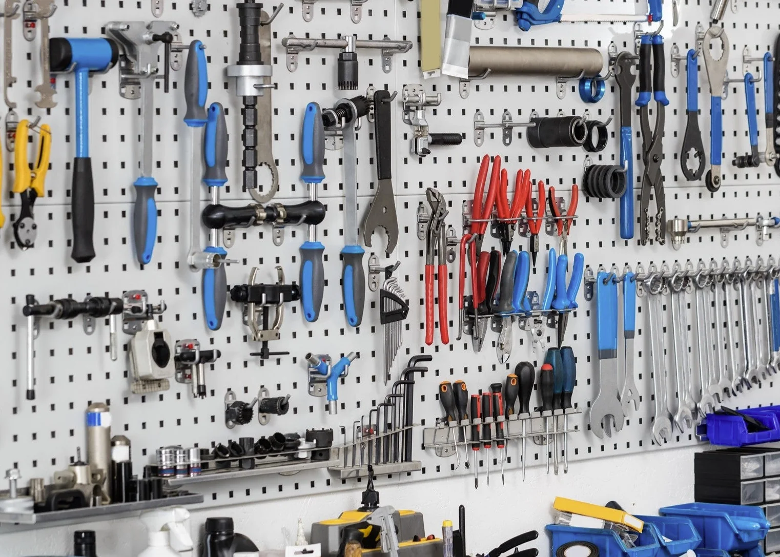
1_Abbildungen/lochwand.png
