DejaVure/RP-Hausarbeit/1_Abbildungen/m16.png

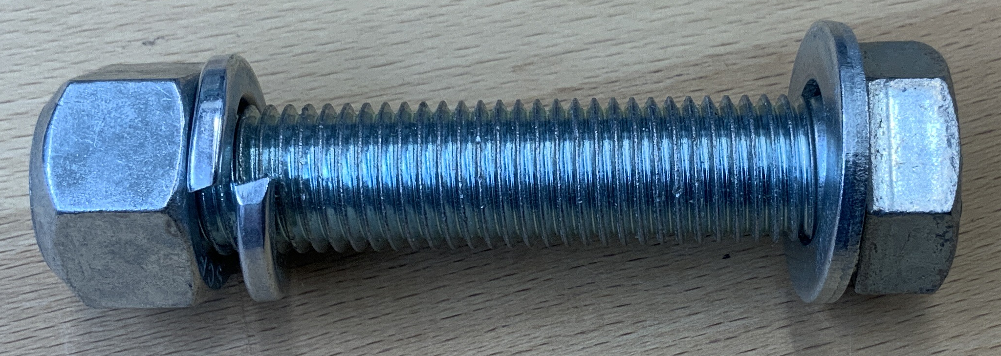
1_Abbildungen/m16.png
