DejaVure/RP-Hausarbeit/1_Abbildungen/m20.png

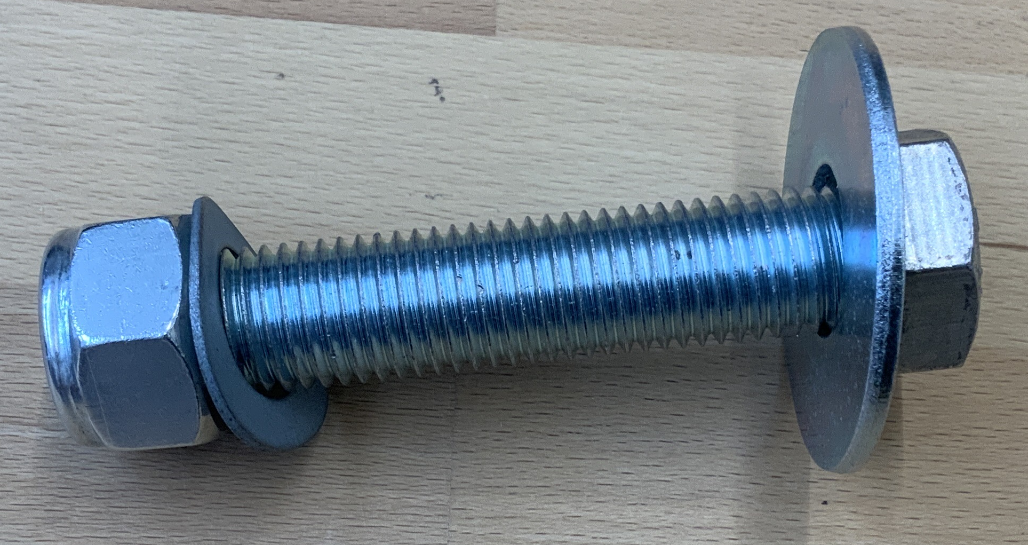
1_Abbildungen/m20.png
