DejaVure/RP-Hausarbeit/1_Abbildungen/m24.png

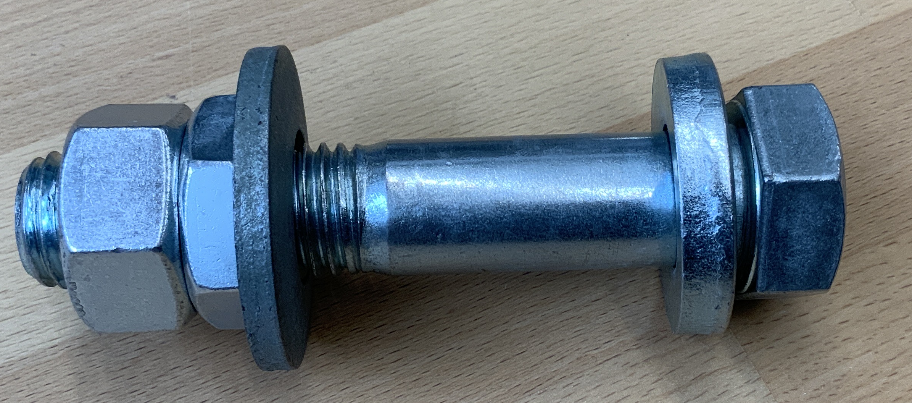
1_Abbildungen/m24.png
