DejaVure/RP-Hausarbeit/1_Abbildungen/Platte in Fusion.png

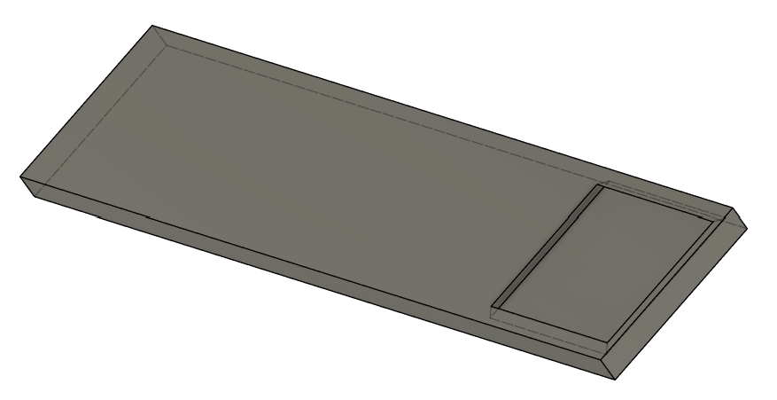
1_Abbildungen/Platte in Fusion.png
