DejaVure/RP-Hausarbeit/1_Abbildungen/schraubenhalter.png

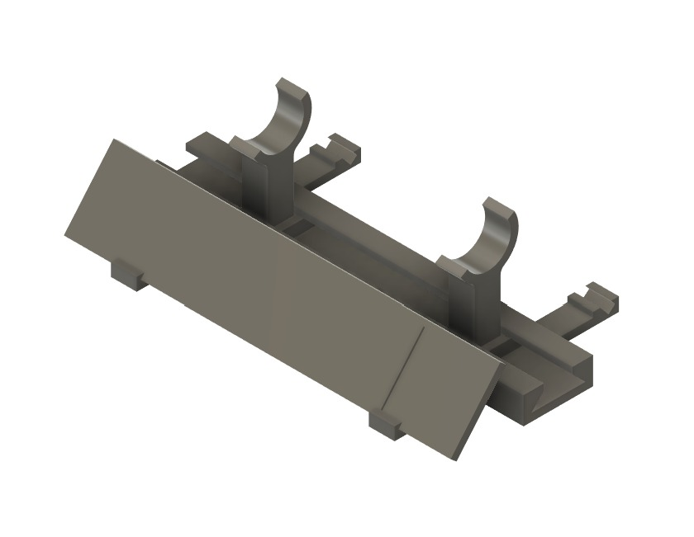
1_Abbildungen/schraubenhalter.png
