DejaVure/RP-Hausarbeit/1_Abbildungen/schraubenhalterFinal.png

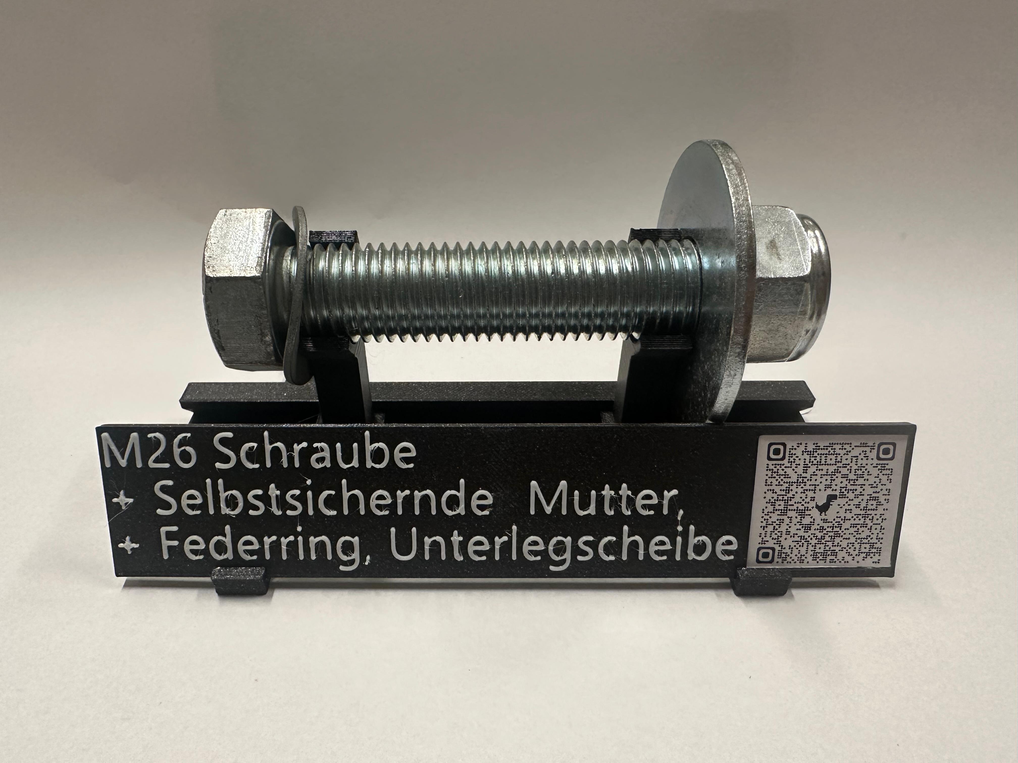
1_Abbildungen/schraubenhalterFinal.png
