DejaVure/RP-Hausarbeit/1_Abbildungen/Schrift der Platten.jpeg

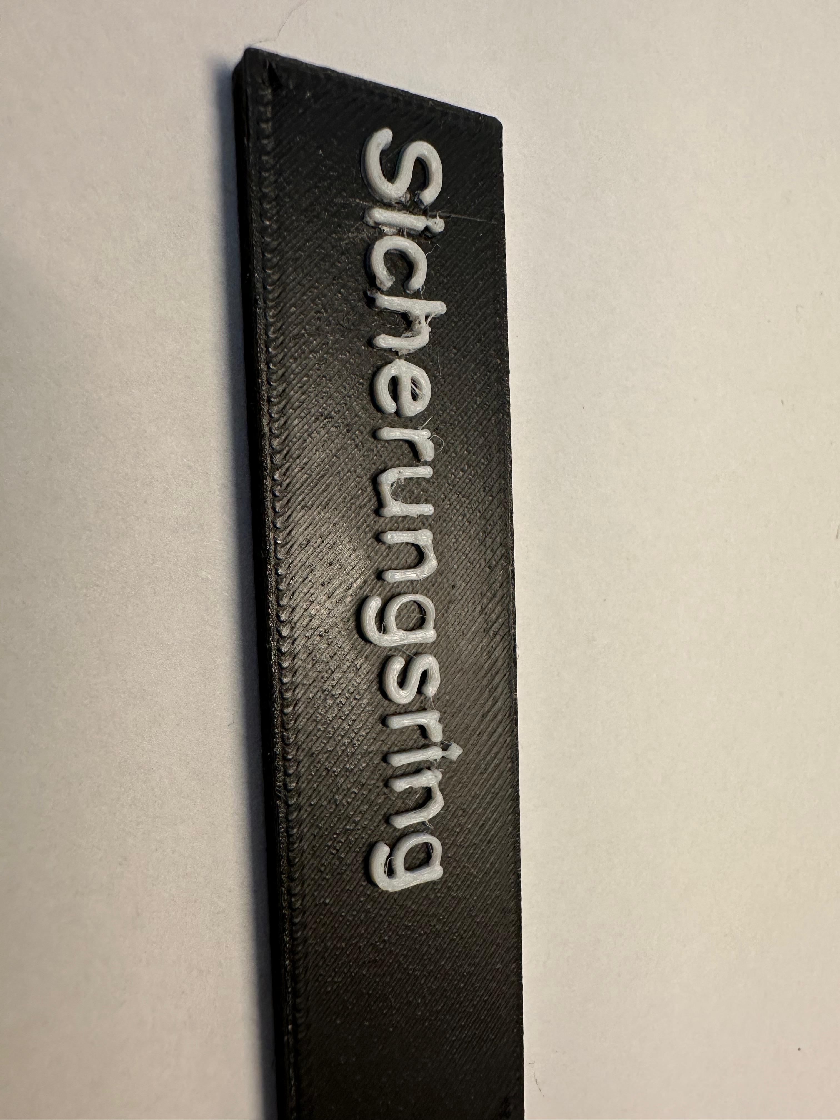
1_Abbildungen/Schrift der Platten.jpeg
