DejaVure/RP-Hausarbeit/1_Abbildungen/wellenhalterFinal.png

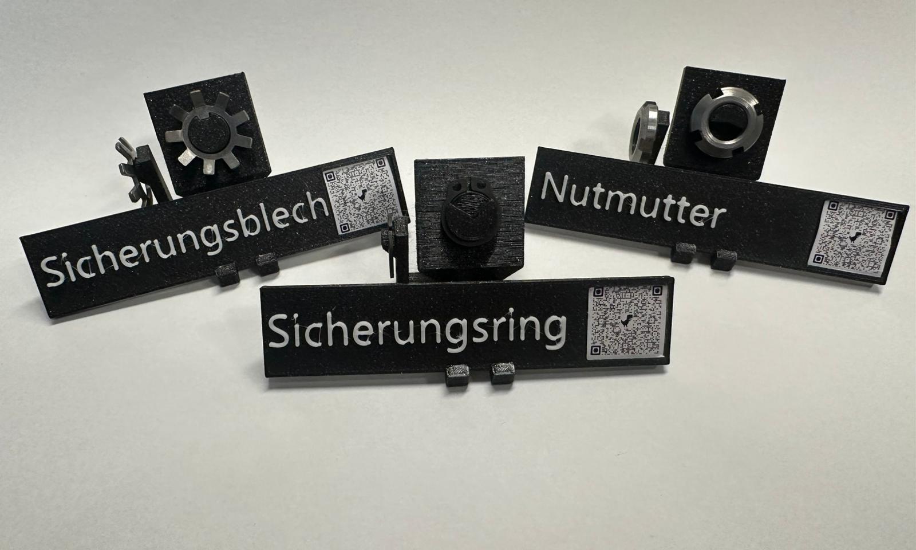
1_Abbildungen/wellenhalterFinal.png
