DejaVure/RP-Hausarbeit/1_Abbildungen/wellensicherungHalter.png

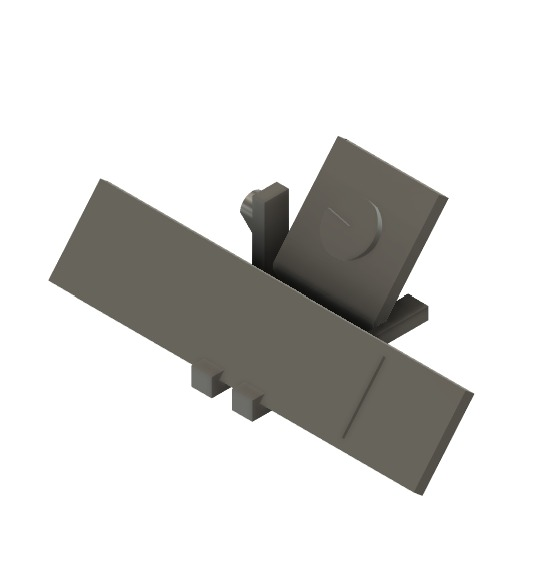
1_Abbildungen/wellensicherungHalter.png
