DejaVure/RP-Hausarbeit/3_Anhang/CAD/Wellensicherungen/Halter Wellensicherungen.SLDASM

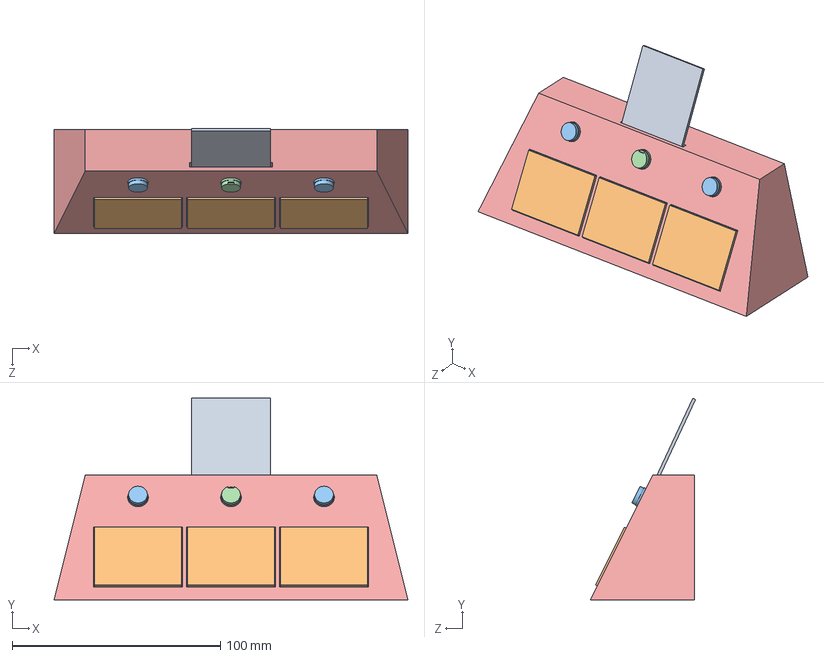
[picture p30: CAD file, 2026-08-25]
3_Anhang/CAD/Wellensicherungen/Halter Wellensicherungen.SLDASM
170.0 x 96.8 x 50.6 mm
Grundplatte Halter
Halter sicherungsblech adapter
Halterungs-Stift x 2
Info-Platte x 3
QR-Code Platte
