DejaVure/RP-Hausarbeit/3_Anhang/CAD/Schraubenhalter/Baugruppe Schraubenhalter.SLDASM

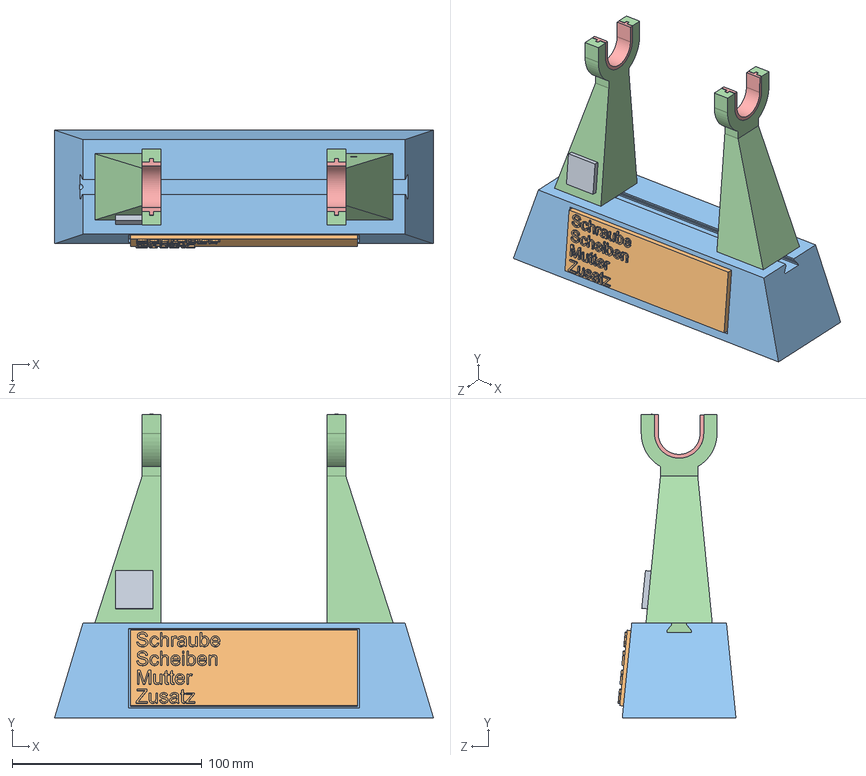
[picture p31: CAD file, 2026-08-25]
3_Anhang/CAD/Schraubenhalter/Baugruppe Schraubenhalter.SLDASM
200.0 x 160.2 x 62.3 mm
Adapter Schrauben (M24) x 2
Haltearm Schrauben (M26) x 2
Halter Schrauben Basis
Informations-Schild
kleine qr-platte schrauben
