DejaVure/RP-Hausarbeit/3_Anhang/CAD/Schraubenhalter/Haltearm Schrauben (M26).SLDPRT

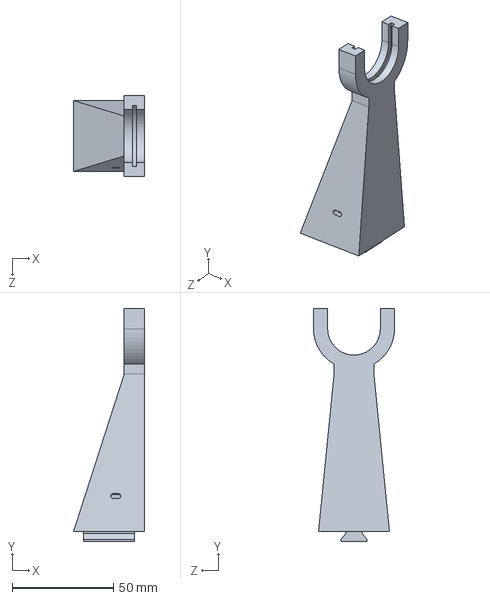
[picture p32: CAD file, 2026-08-25]
3_Anhang/CAD/Schraubenhalter/Haltearm Schrauben (M26).SLDPRT
35.0 x 115.0 x 40.0 mm
