DejaVure/RP-Hausarbeit/3_Anhang/CAD/Wellensicherungen/Grundplatte Halter.SLDPRT

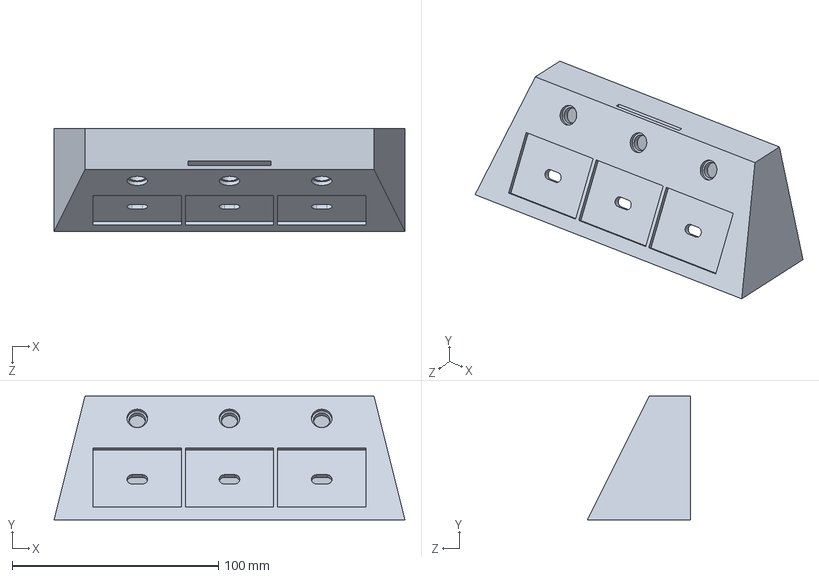
[picture p33: CAD file, 2026-08-25]
3_Anhang/CAD/Wellensicherungen/Grundplatte Halter.SLDPRT
170.0 x 60.0 x 50.0 mm
