DejaVure/RP-Hausarbeit/3_Anhang/CAD/Schraubenhalter/kleine qr-platte schrauben.SLDPRT

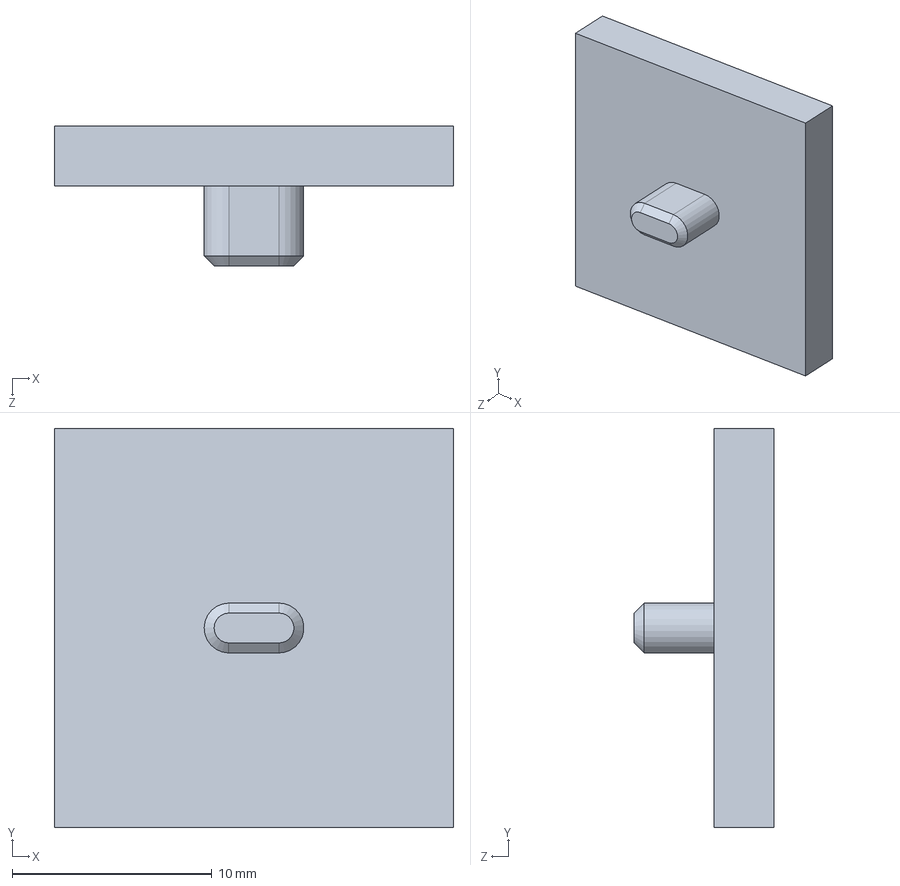
[picture p34: CAD file, 2026-08-25]
3_Anhang/CAD/Schraubenhalter/kleine qr-platte schrauben.SLDPRT
20.0 x 20.0 x 7.00 mm
