DejaVure/RP-Hausarbeit/3_Anhang/CAD/Wellensicherungen/Halter sicherungsblech adapter.SLDPRT

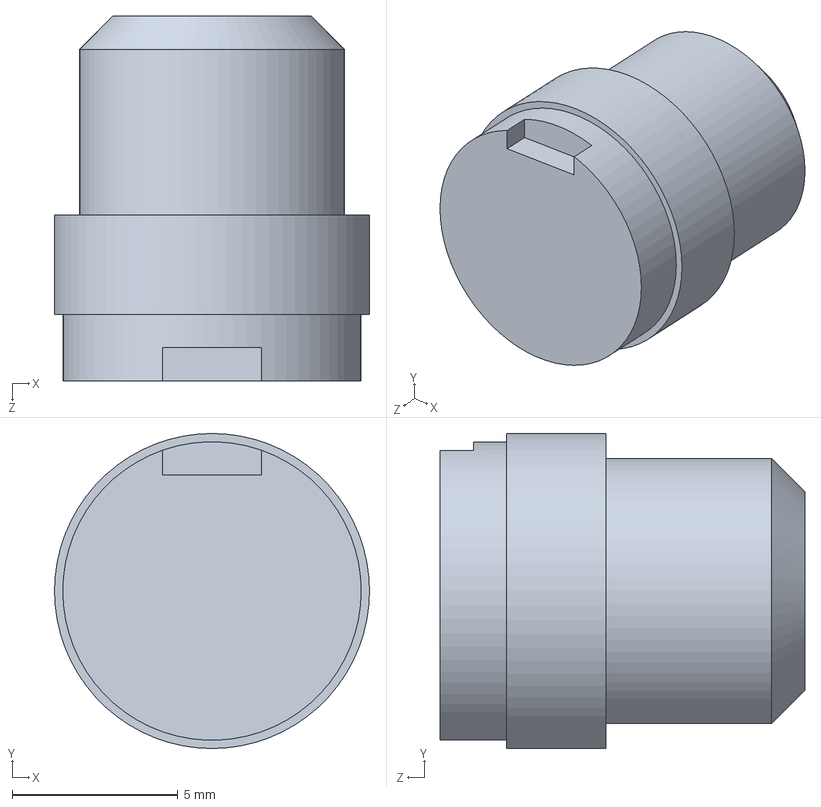
[picture p35: CAD file, 2026-08-25]
3_Anhang/CAD/Wellensicherungen/Halter sicherungsblech adapter.SLDPRT
9.50 x 9.50 x 11.0 mm
