DejaVure/RP-Hausarbeit/3_Anhang/CAD/Schraubenhalter/Adapter Schrauben (M20).SLDPRT

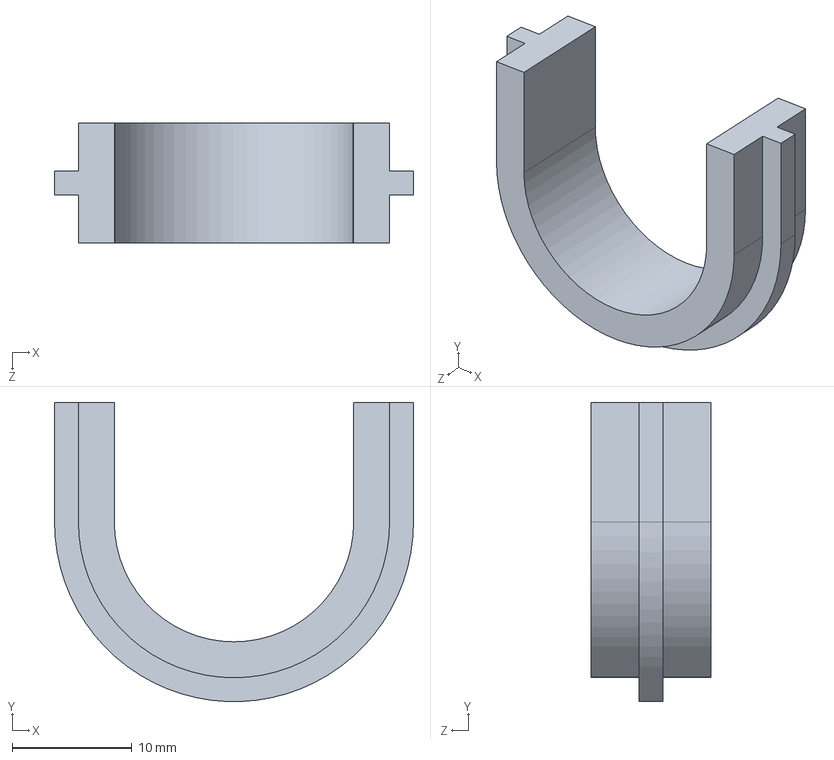
[picture p36: CAD file, 2026-08-25]
3_Anhang/CAD/Schraubenhalter/Adapter Schrauben (M20).SLDPRT
30.0 x 25.0 x 10.0 mm
