DejaVure/RP-Hausarbeit/3_Anhang/CAD/Wellensicherungen/Info-Platte.SLDPRT

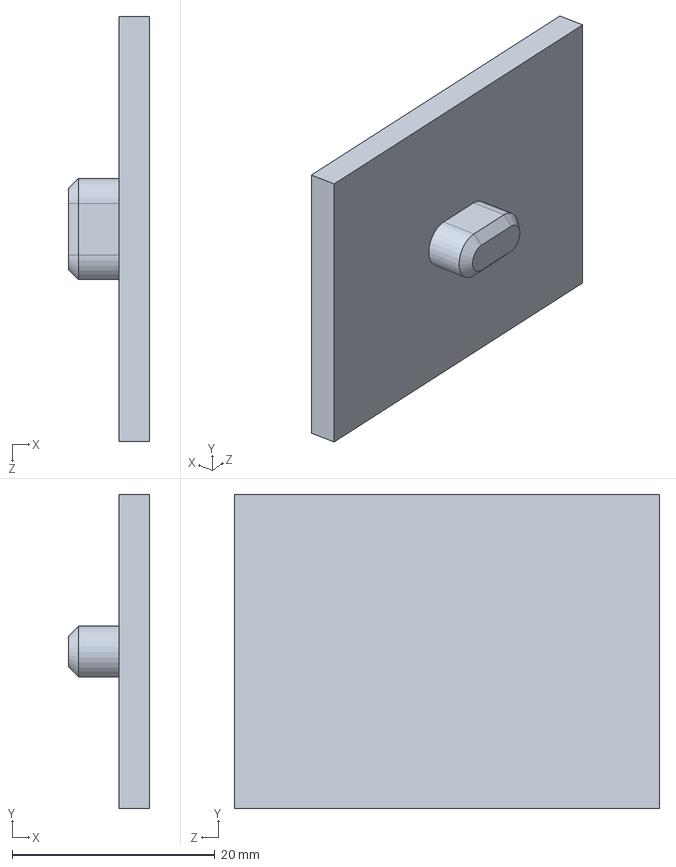
[picture p38: CAD file, 2026-08-25]
3_Anhang/CAD/Wellensicherungen/Info-Platte.SLDPRT
8.00 x 31.0 x 42.0 mm
