DejaVure/RP-Hausarbeit/3_Anhang/CAD/Schraubenhalter/Halter Schrauben Basis.SLDPRT

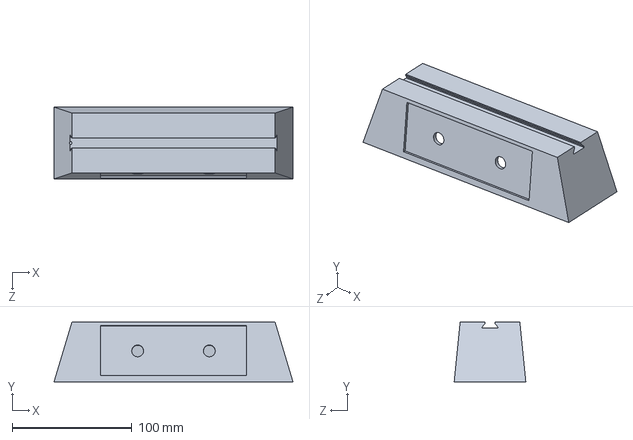
[picture p39: CAD file, 2026-08-25]
3_Anhang/CAD/Schraubenhalter/Halter Schrauben Basis.SLDPRT
200.0 x 50.0 x 60.0 mm
