DejaVure/RP-Hausarbeit/3_Anhang/CAD/Wellensicherungen/QR-Code Platte.SLDPRT

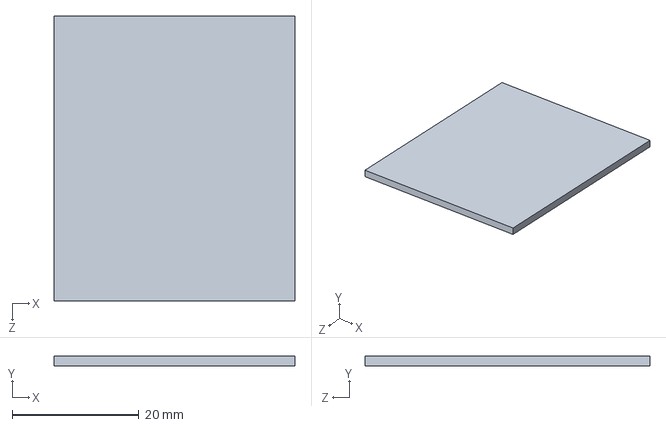
[picture p40: CAD file, 2026-08-25]
3_Anhang/CAD/Wellensicherungen/QR-Code Platte.SLDPRT
38.0 x 1.50 x 45.0 mm
