DejaVure/RP-Hausarbeit/3_Anhang/CAD/Schraubenhalter/Informations-Schild.SLDPRT

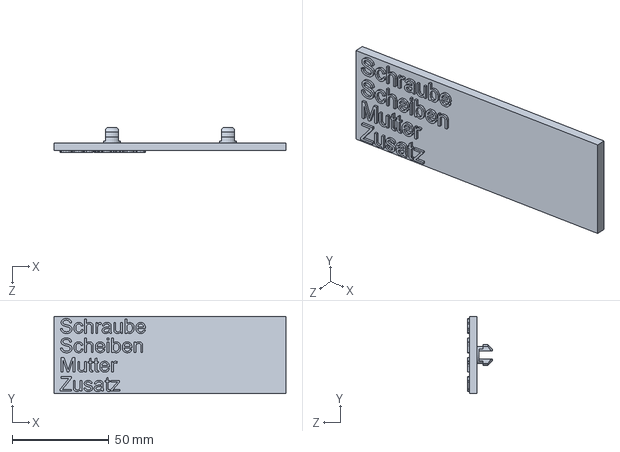
[picture p41: CAD file, 2026-08-25]
3_Anhang/CAD/Schraubenhalter/Informations-Schild.SLDPRT
120.0 x 40.0 x 13.1 mm
