DejaVure/RP-Hausarbeit/3_Anhang/CAD/Schraubenhalter/Adapter Schrauben (M16).SLDPRT

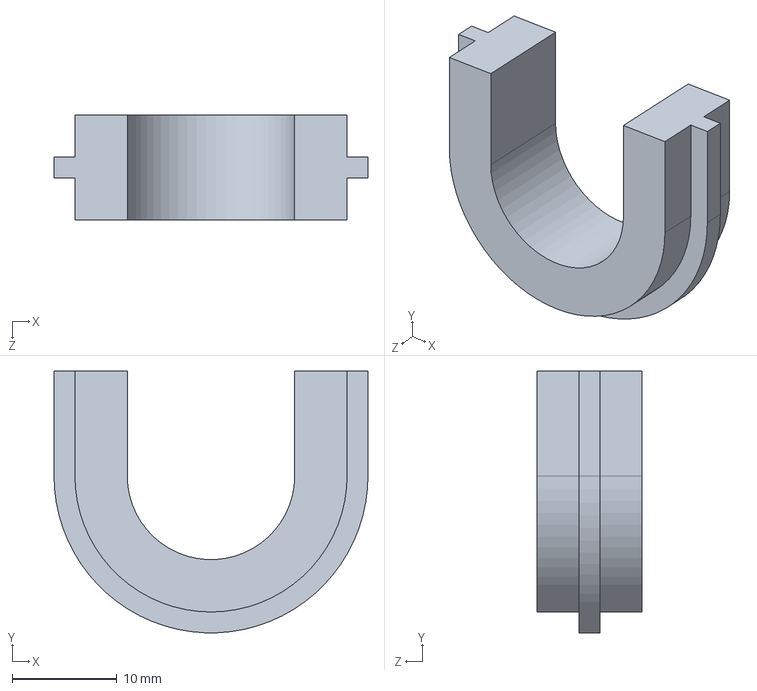
[picture p42: CAD file, 2026-08-25]
3_Anhang/CAD/Schraubenhalter/Adapter Schrauben (M16).SLDPRT
30.0 x 25.0 x 10.0 mm
