DejaVure/RP-Hausarbeit/(list of files, cad)

Other CAD files:
3_Anhang/CAD/Wellensicherungen/Halterungs-Stift.SLDPRT
