DejaVure/RP-Hausarbeit/3_Anhang/Zeichnungen/Schraubenhalter.pdf

87 | 10 10 0 - 118 16 | 150 | 27.5

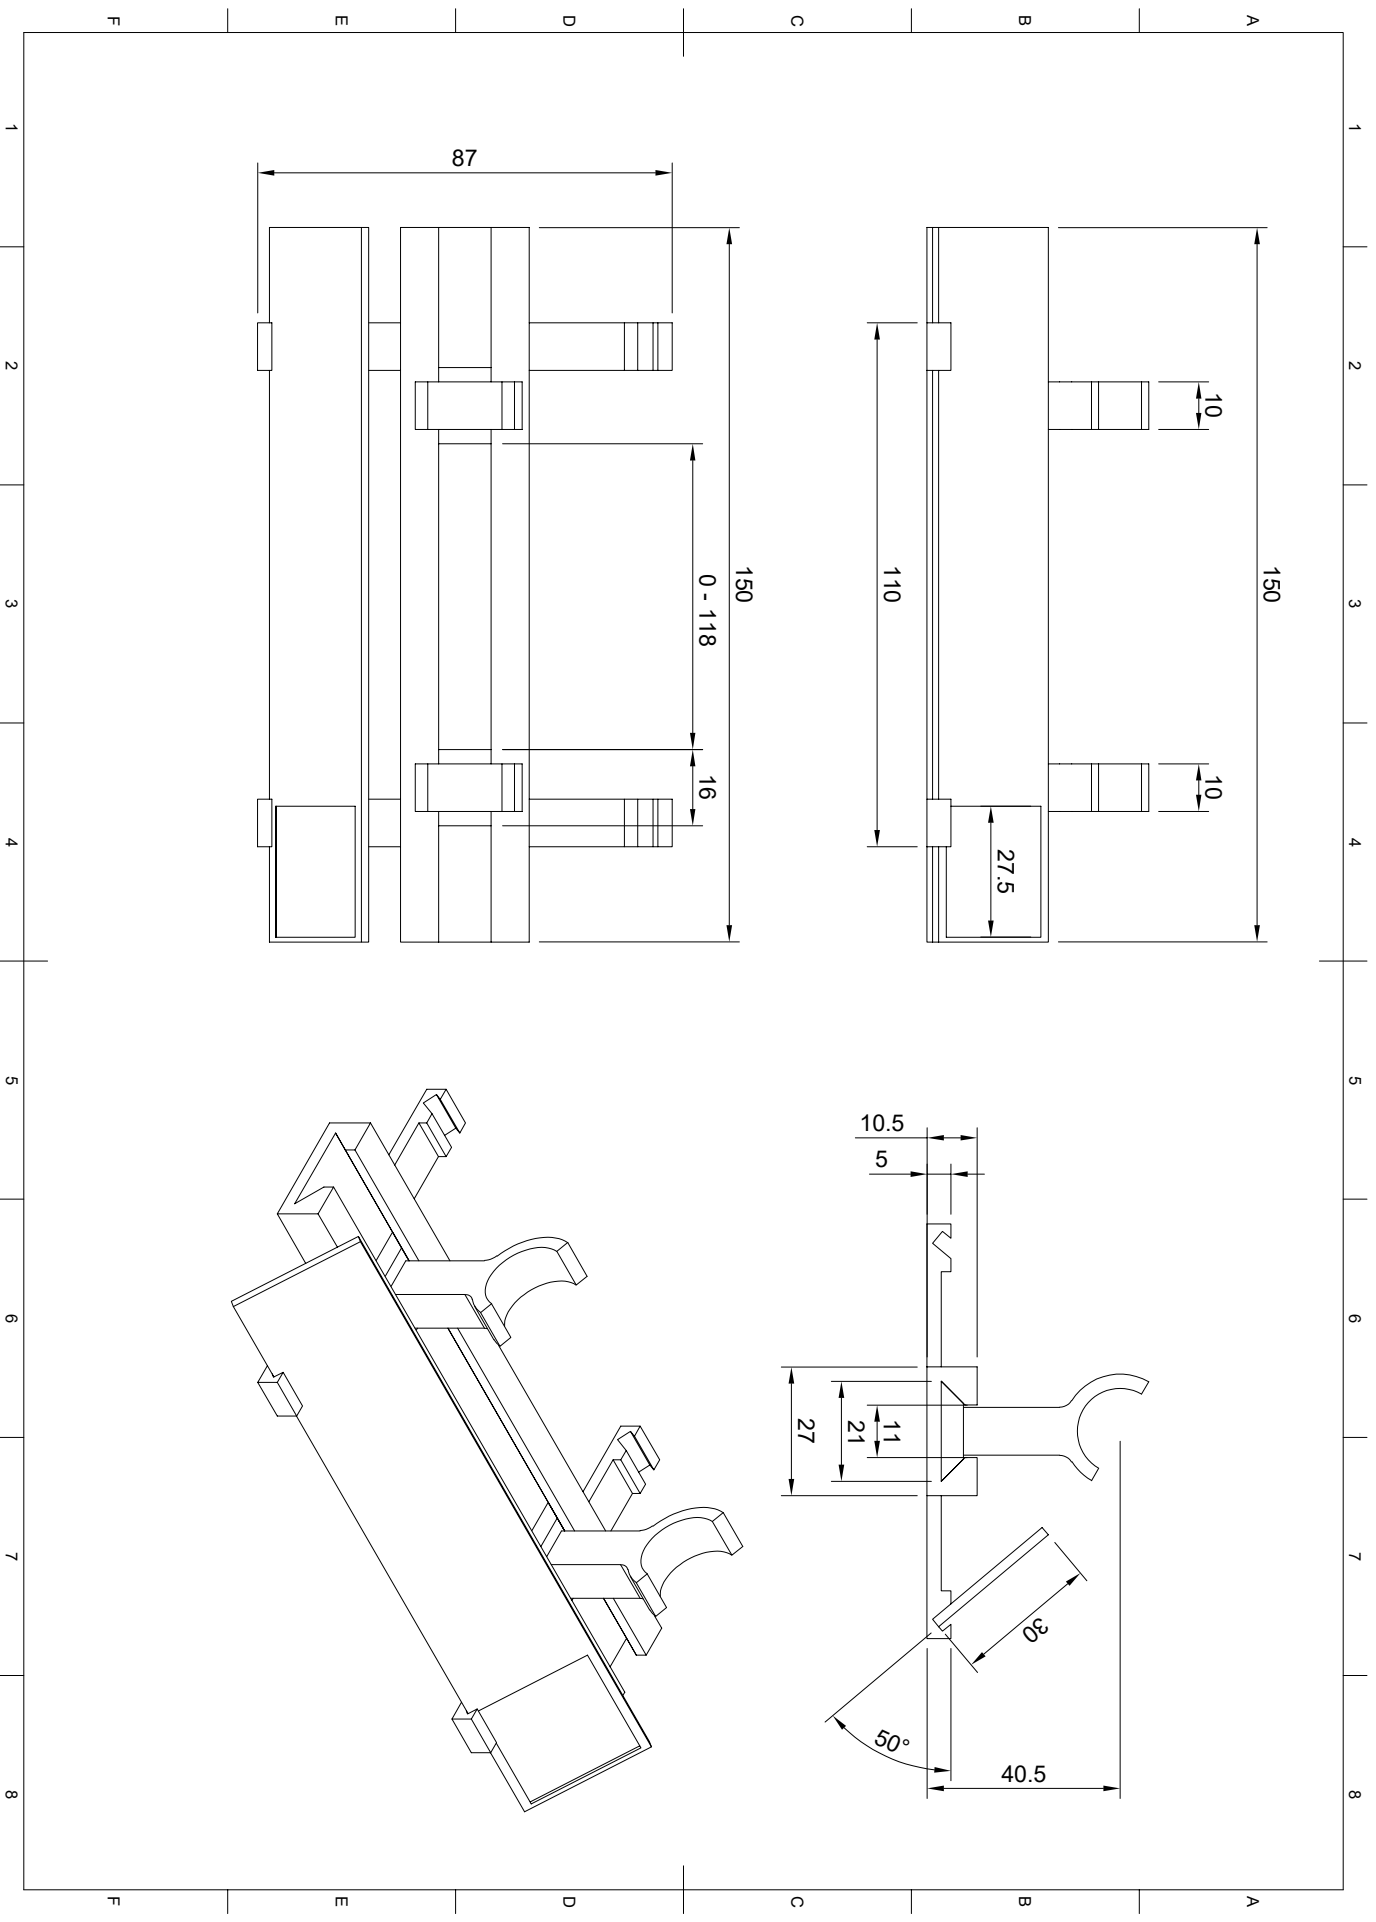
[picture p43: page 1]
1 A 2 3 4 5 6 7 8 1 2 3 4 5 6 7 8 FEDCB FEDCBA; 30 ¹¹⁰
