DejaVure/RP-Hausarbeit/3_Anhang/Zeichnungen/Wellensicherung.pdf

30.24 ¹⁵ | 25 | 90 8 6 | 20 ³³ | 4.62 | 6
18 | 18 | 2 A | A A-A (1:1)1816 0.820 2.8 B | B 8° | B-B (1:1) 12.525

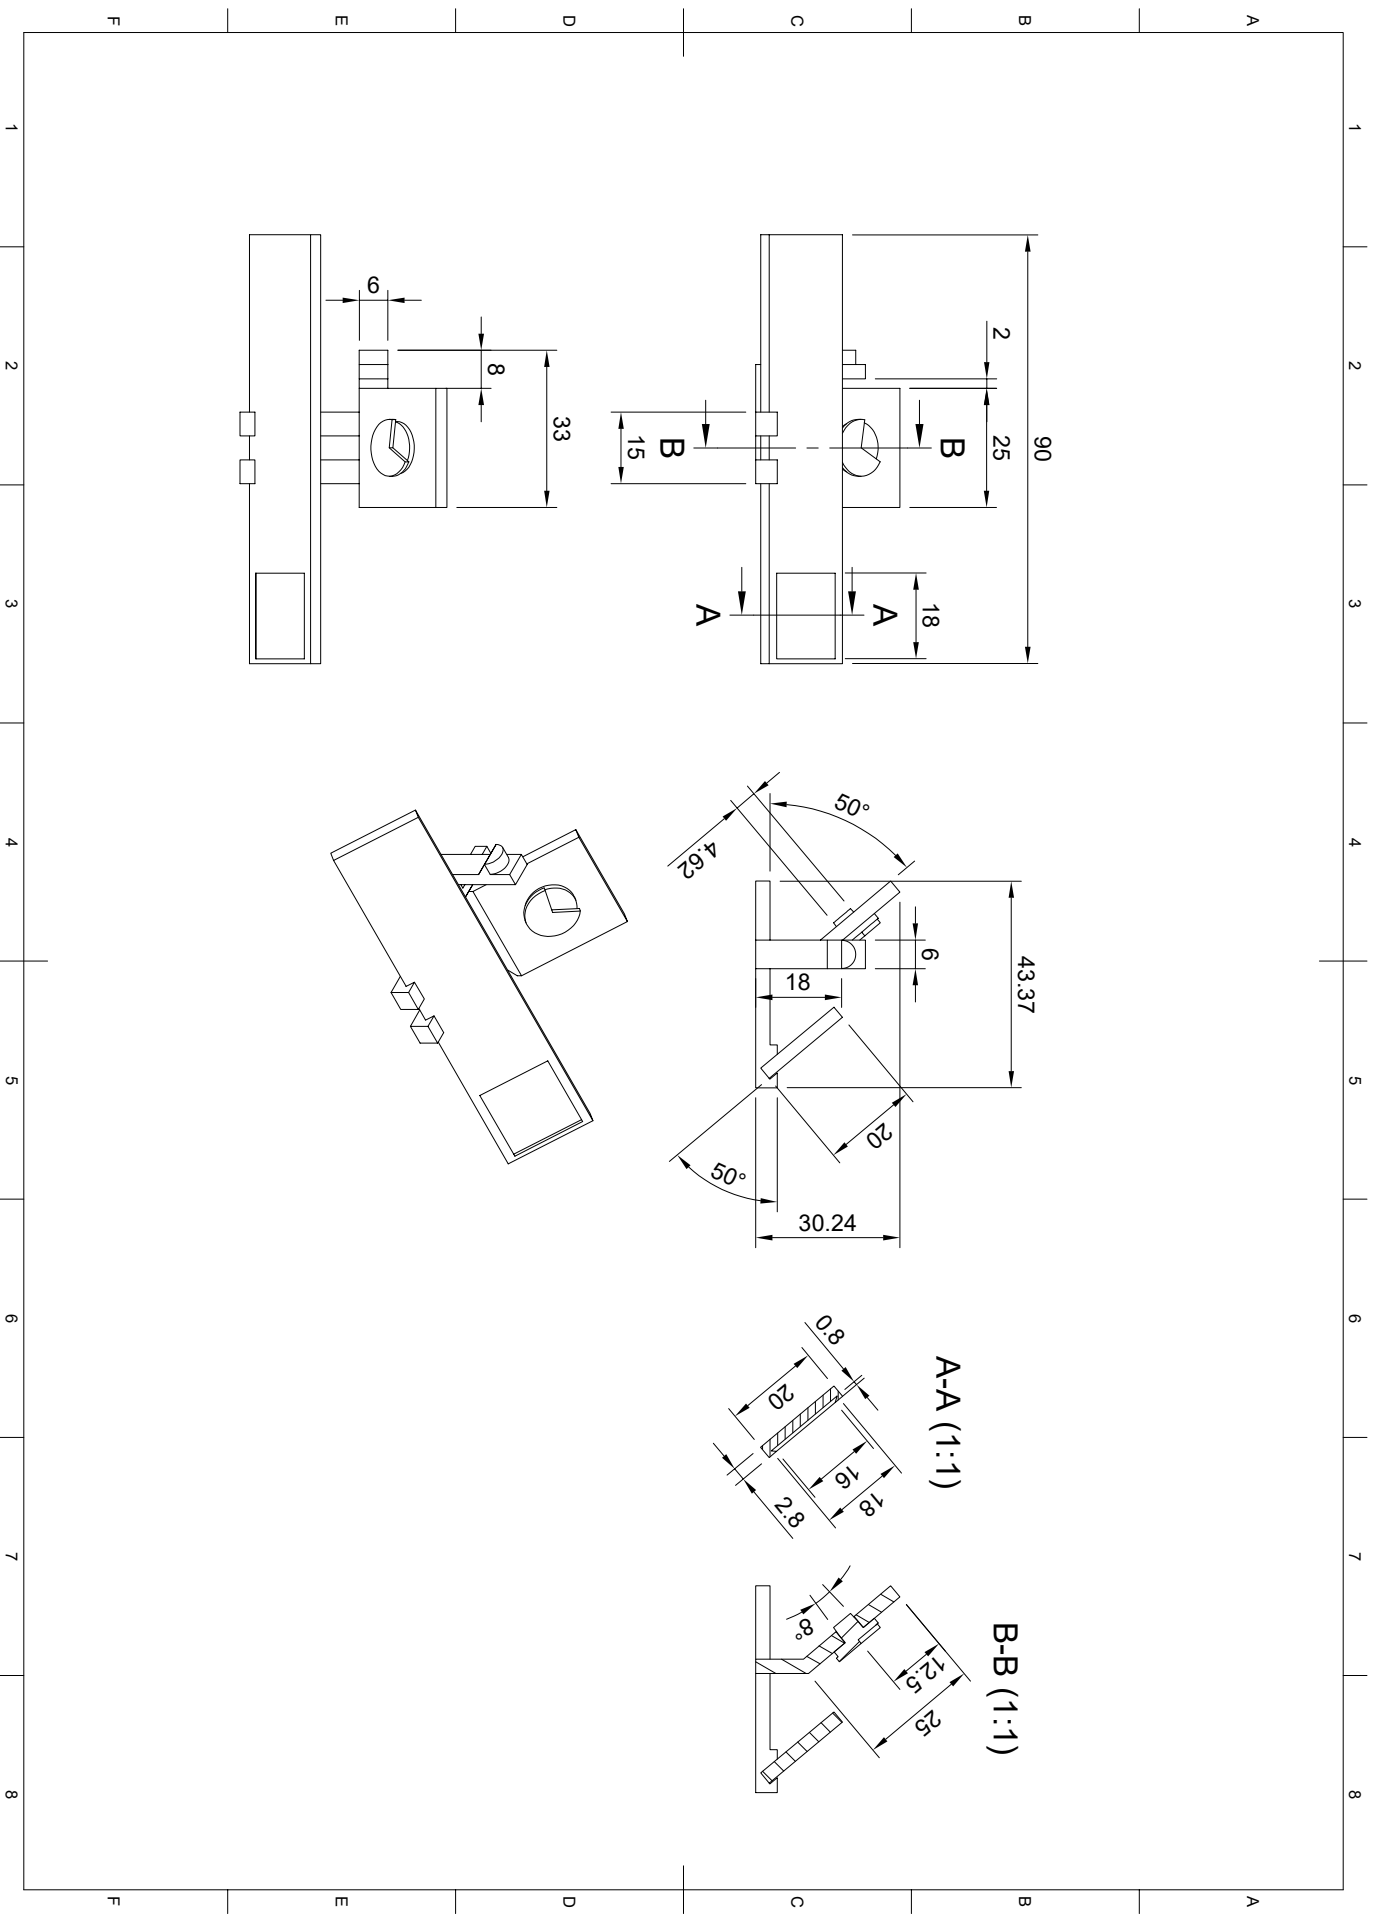
[picture p44: page 1]
1 A 2 3 4 5 6 7 8 1 2 3 4 5 6 7 8 FEDCB FEDCBA 50° 50° 43.37
