DejaVure/RP-Hausarbeit/(commit log)

2026-08-25 CAD angefangen
    [Adapter Schrauben (M16).SLDPRT, Adapter Schrauben (M20).SLDPRT, Adapter Schrauben (M24).SLDPRT, Baugruppe Schraubenhalter.SLDASM, Haltearm Schrauben (M26).SLDPRT, Halter Schrauben Basis.SLDPRT, Informations-Schild.SLDPRT, kleine qr-platte schrauben.SLDPRT]
2026-08-25 wellensicherung halter hinzugefügt
    [Adapter Schrauben (M16).SLDPRT, Adapter Schrauben (M20).SLDPRT, Adapter Schrauben (M24).SLDPRT, Baugruppe Schraubenhalter.SLDASM, Grundplatte Halter.SLDPRT, Haltearm Schrauben (M26).SLDPRT, Halter Schrauben Basis.SLDPRT, Halter Wellensicherungen.SLDASM]
2026-08-28 Stand der Technik
2026-08-28 stand der Technik weitergemacht
2026-08-28 Stand der Technik fertig
